jackm2983/SENIOR-PROJECT/README.md

# Senior Project 2025-26
Cal Poly SLO EE

### Team Members
* **Wyatt Tack**
* **Jack Marshall**
* **Ryken Thompson**
* **Cameron Young**

### Advisor
* **Dr. Nishith Chakraborty**

## Software
* Vivado 2024.2
* OpenLane & Magic VLSI

## Photos
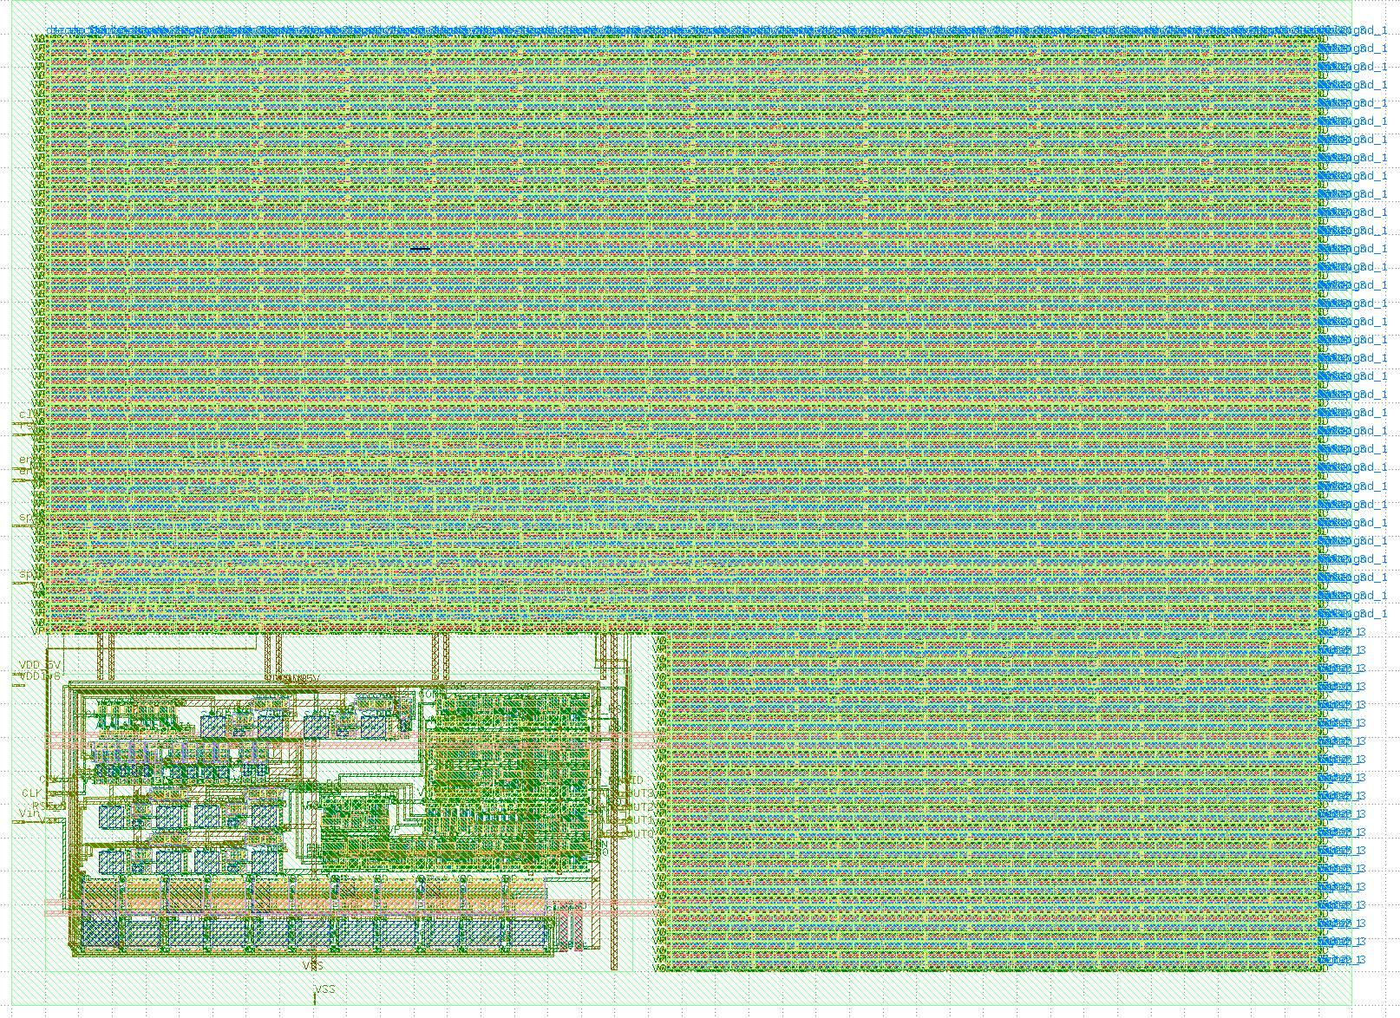
[picture p1: Misc/Photos/klayout_final.png]

*KLayout final layout*

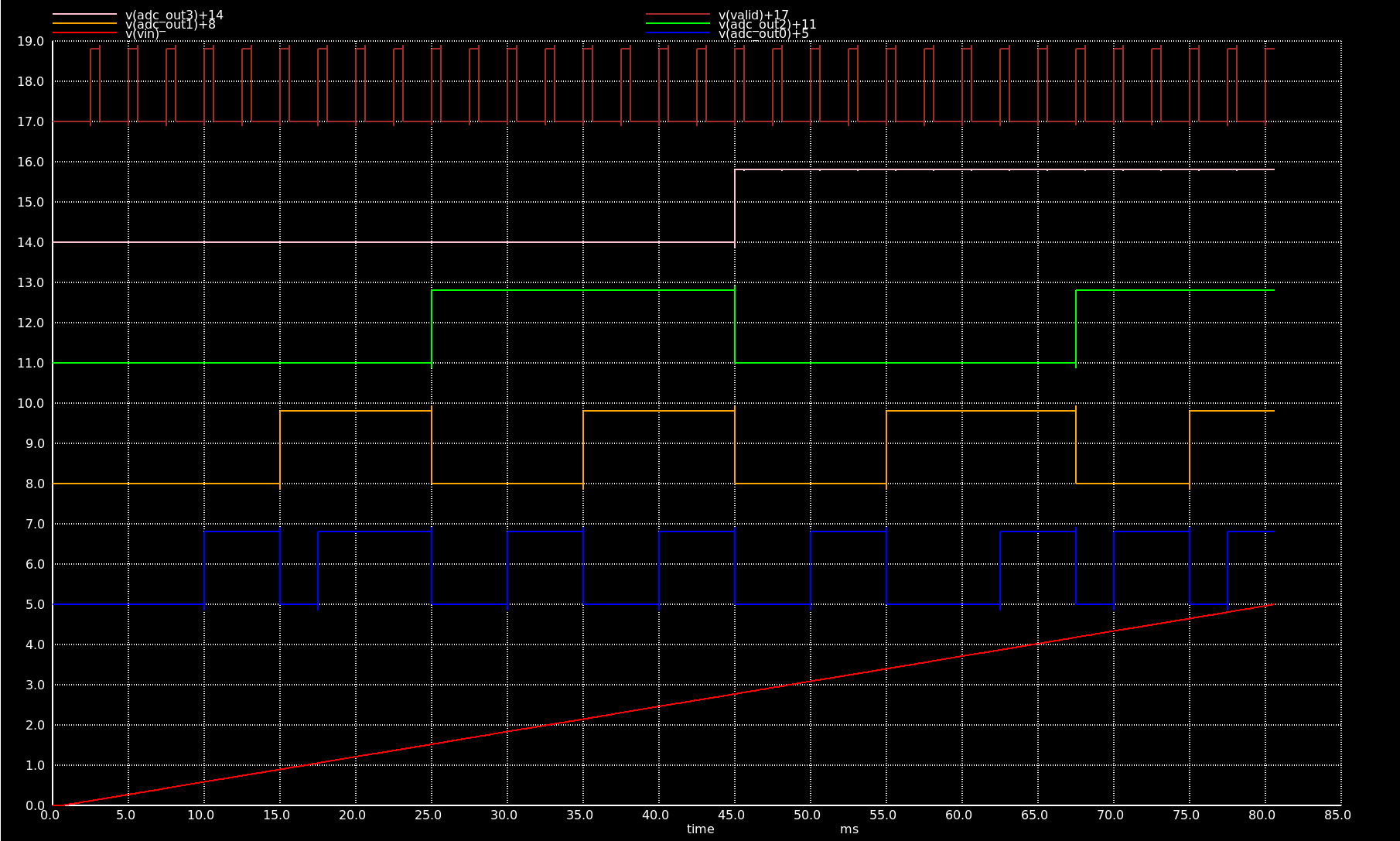
[picture p2: Misc/Photos/ADC_paracitic_noreset.png]

*ADC full-scale range simulation*


*Encoding Schemes*
