jackm2983/SENIOR-PROJECT/FPGA/README.md

SNN_Encoder is the proof of concept for the spike encoder designs. 

FPGA_Encoder+SNN+UART is the complete design with FPGA implementation and UART communication.
