jackm2983/SENIOR-PROJECT/ADC/4bit_C2C/CDAC Implementation Notes.pdf

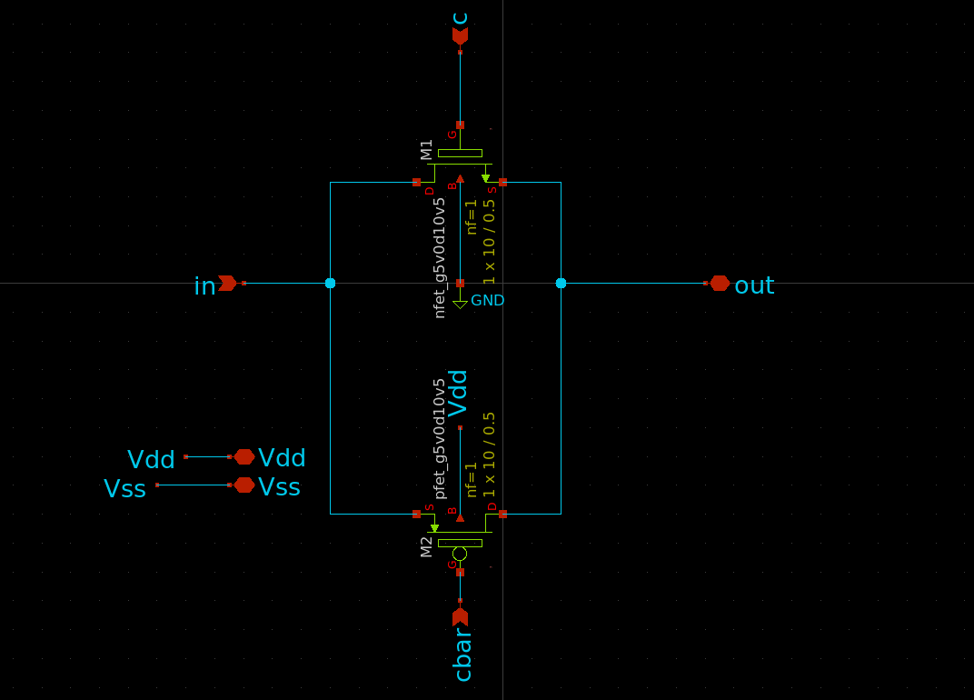
[picture p7: figure]

T Gate Schematic

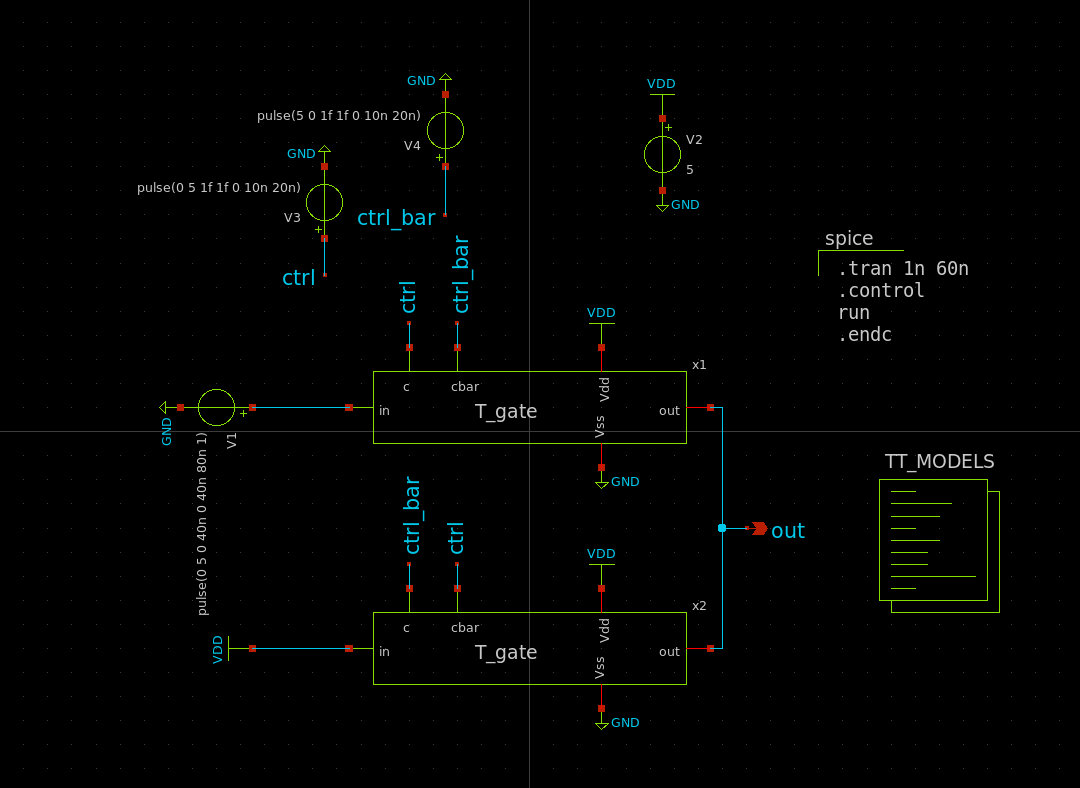
[picture p8: figure]

T-Gate SPDT Switch Operation Test Bench

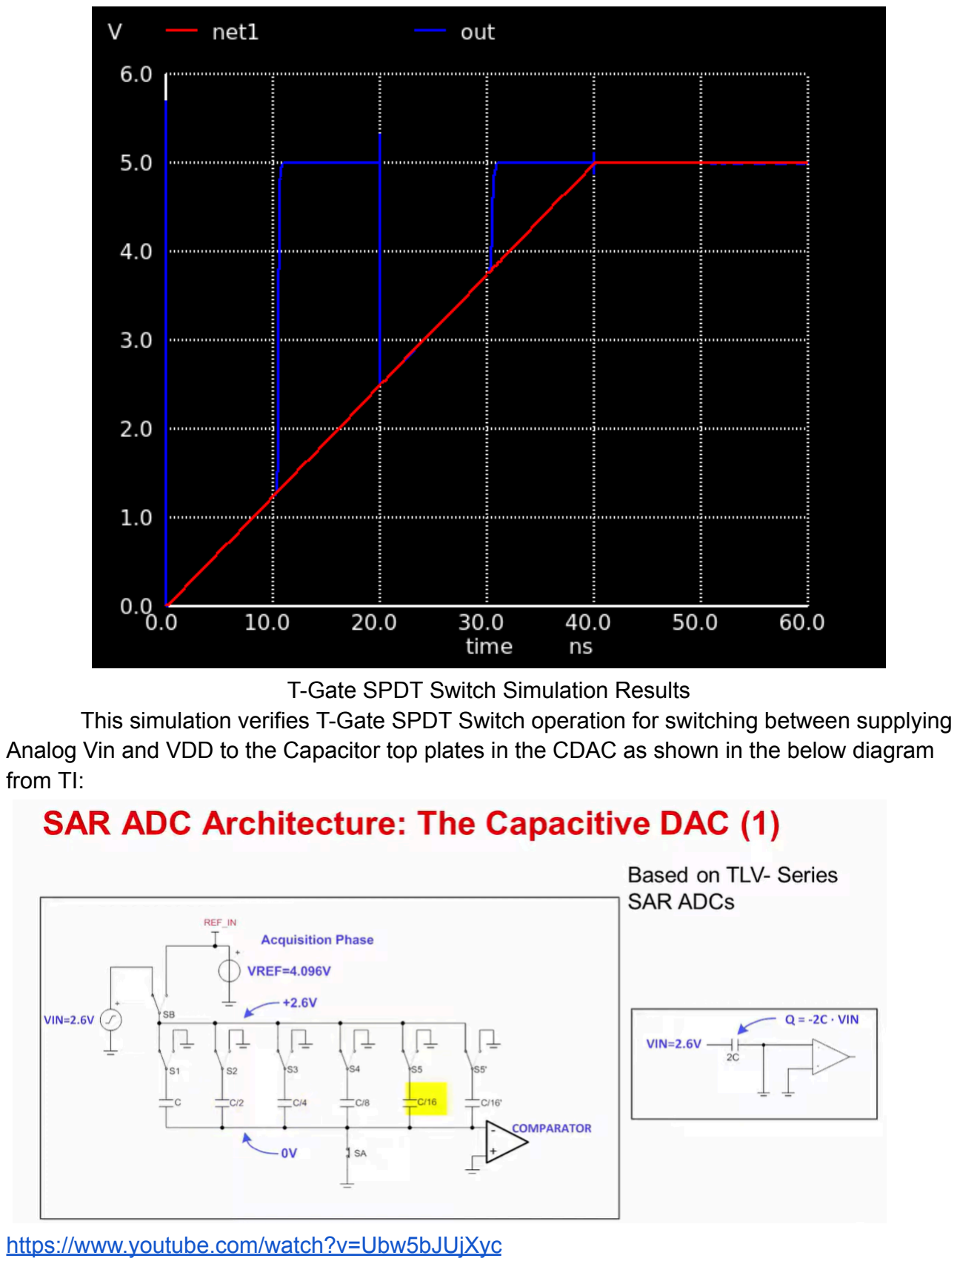
[picture p9: page 3]

T-Gate SPDT Switch Simulation Results This simulation verifies T-Gate SPDT Switch operation for switching between supplying Analog Vin and VDD to the Capacitor top plates in the CDAC as shown in the below diagram from TI:

https://www.youtube.com/watch?v=Ubw5bJUjXyc

Next, for more compact simulation at the top level I wanted to package this SPDT switch into its own subcircuit

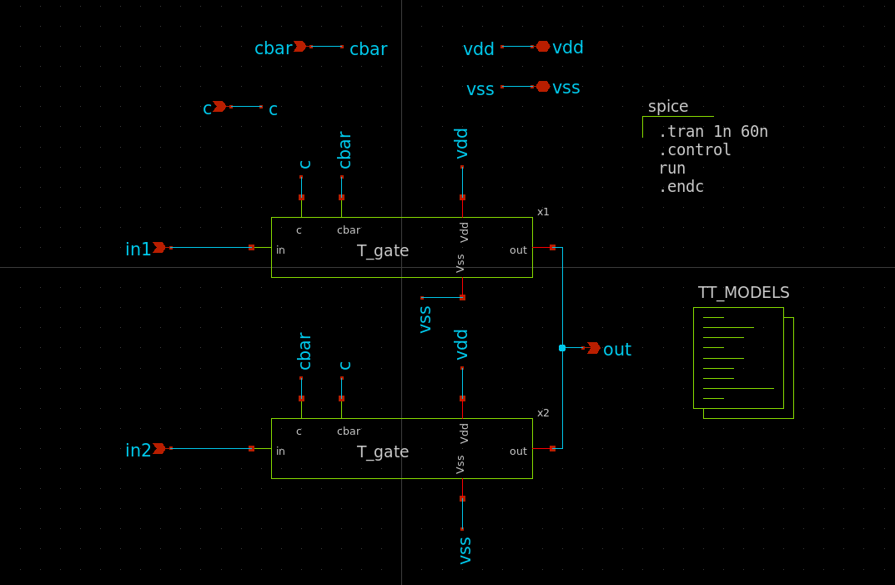
[picture p10: figure]

SPDT Schematic

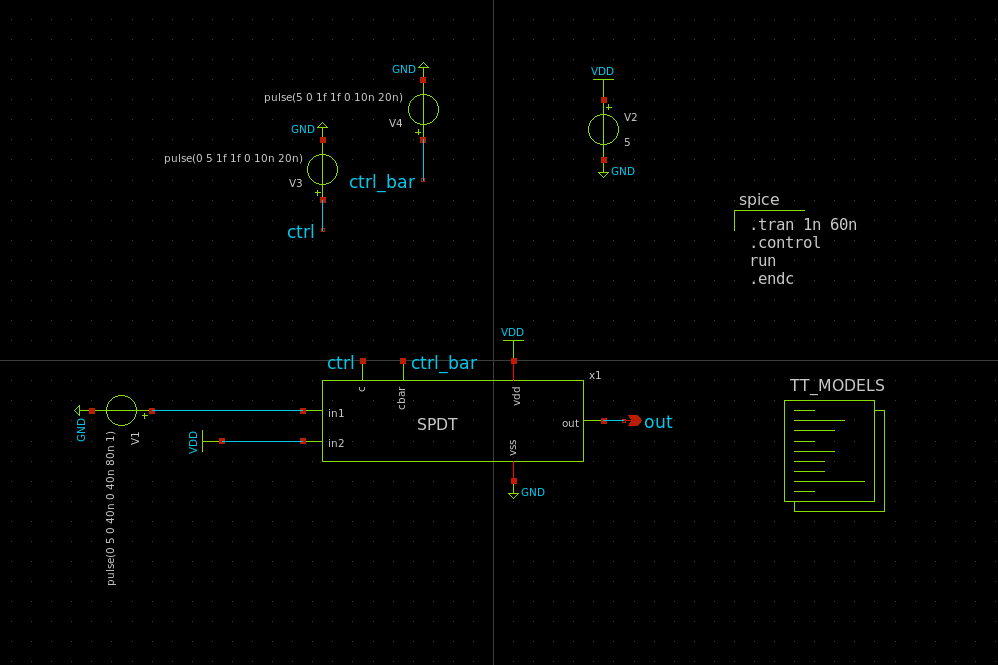
[picture p11: figure]

SPDT Test Bench

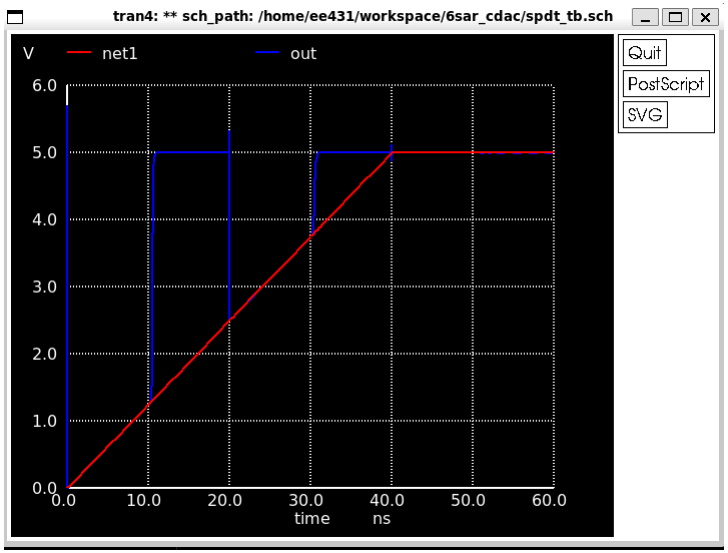
[picture p12: figure]

SPDT Simulation Results
This shows successful operation of the SPDT to pass analog inputs and VDD. This can be used in the CDAC implementation

Common mode switching CDAC

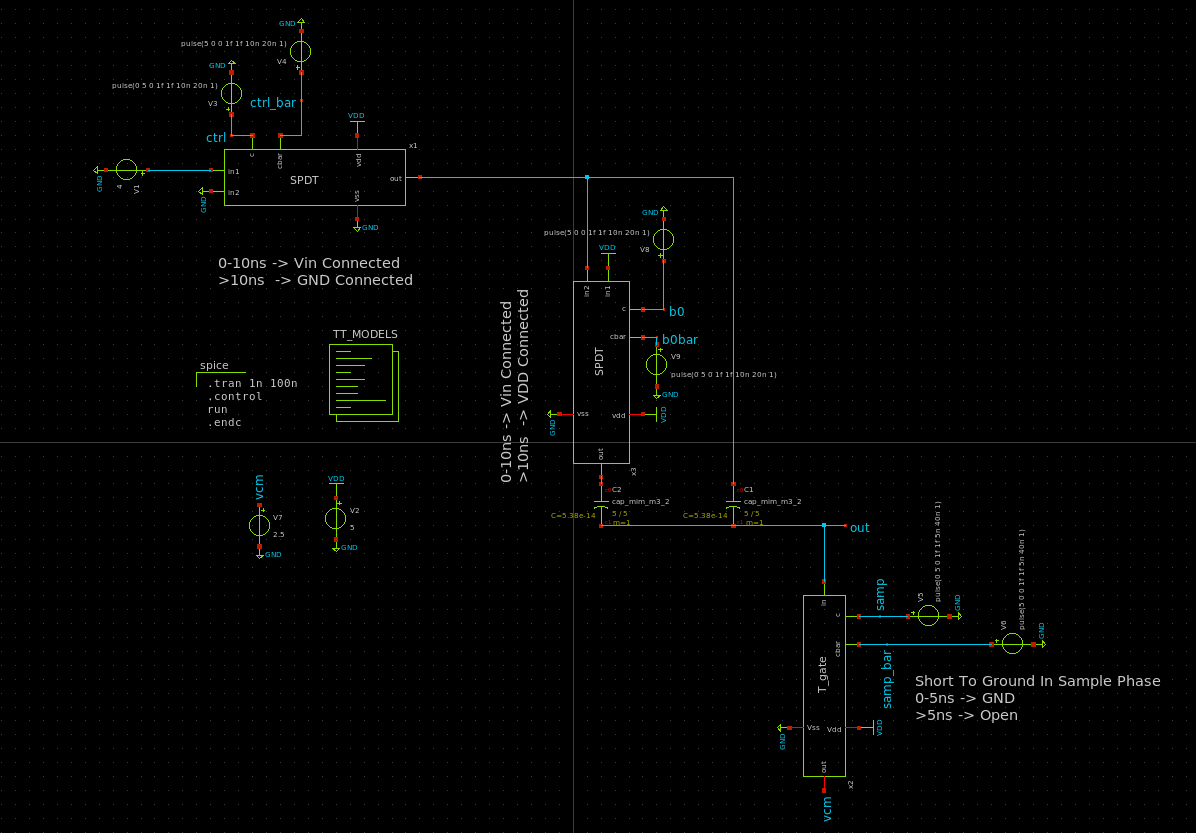
[picture p13: figure]

First Successful Common Mode Switching CDAC (1 bit)

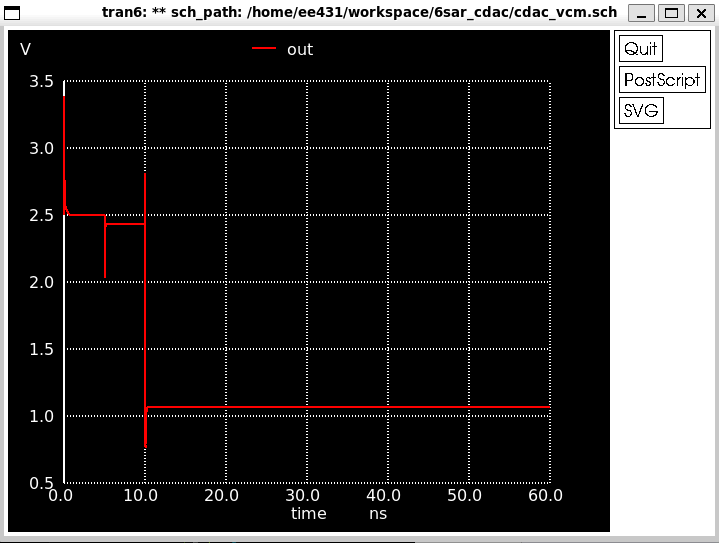
[picture p14: figure]

Simulation Results
Vout = 1V = Vcm - Vin + Vguess = 2.5 - 4 + 2.5
