jackm2983/SENIOR-PROJECT/Misc/Photos/ADC.png

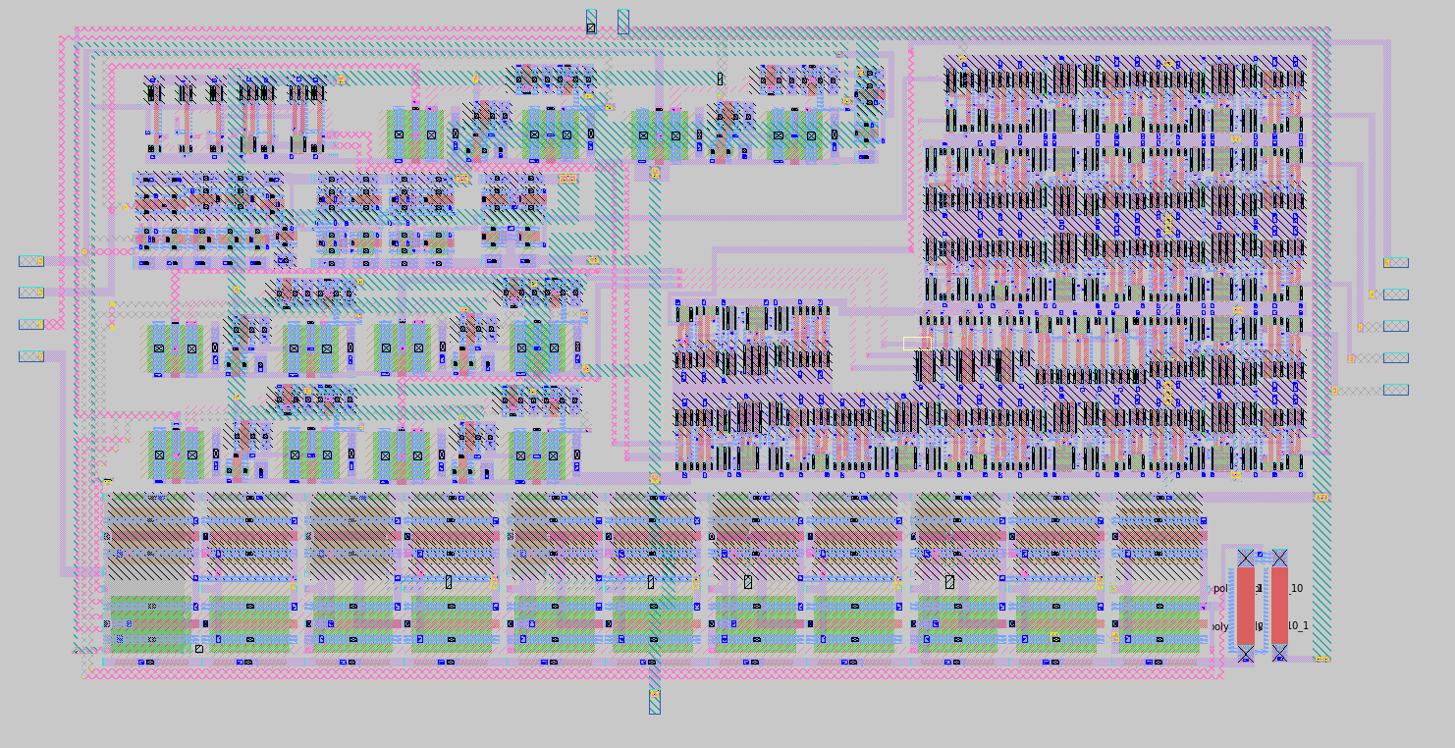
Misc/Photos/ADC.png
