jackm2983/SENIOR-PROJECT/Misc/Photos/adc_fsr_sim.png

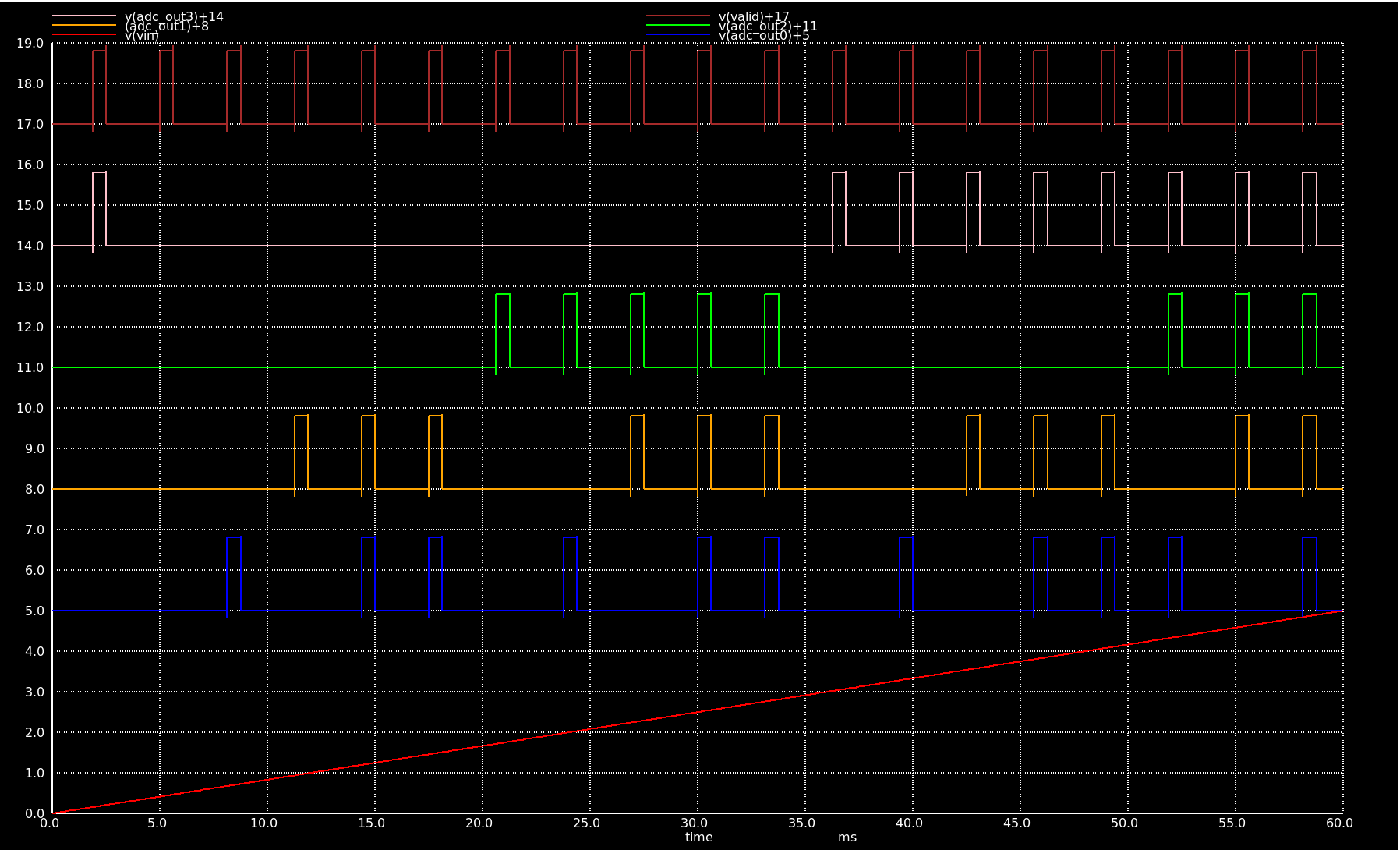
Misc/Photos/adc_fsr_sim.png
