jackm2983/SENIOR-PROJECT/Misc/Photos/adc_fsr_sim_withparacitics.png

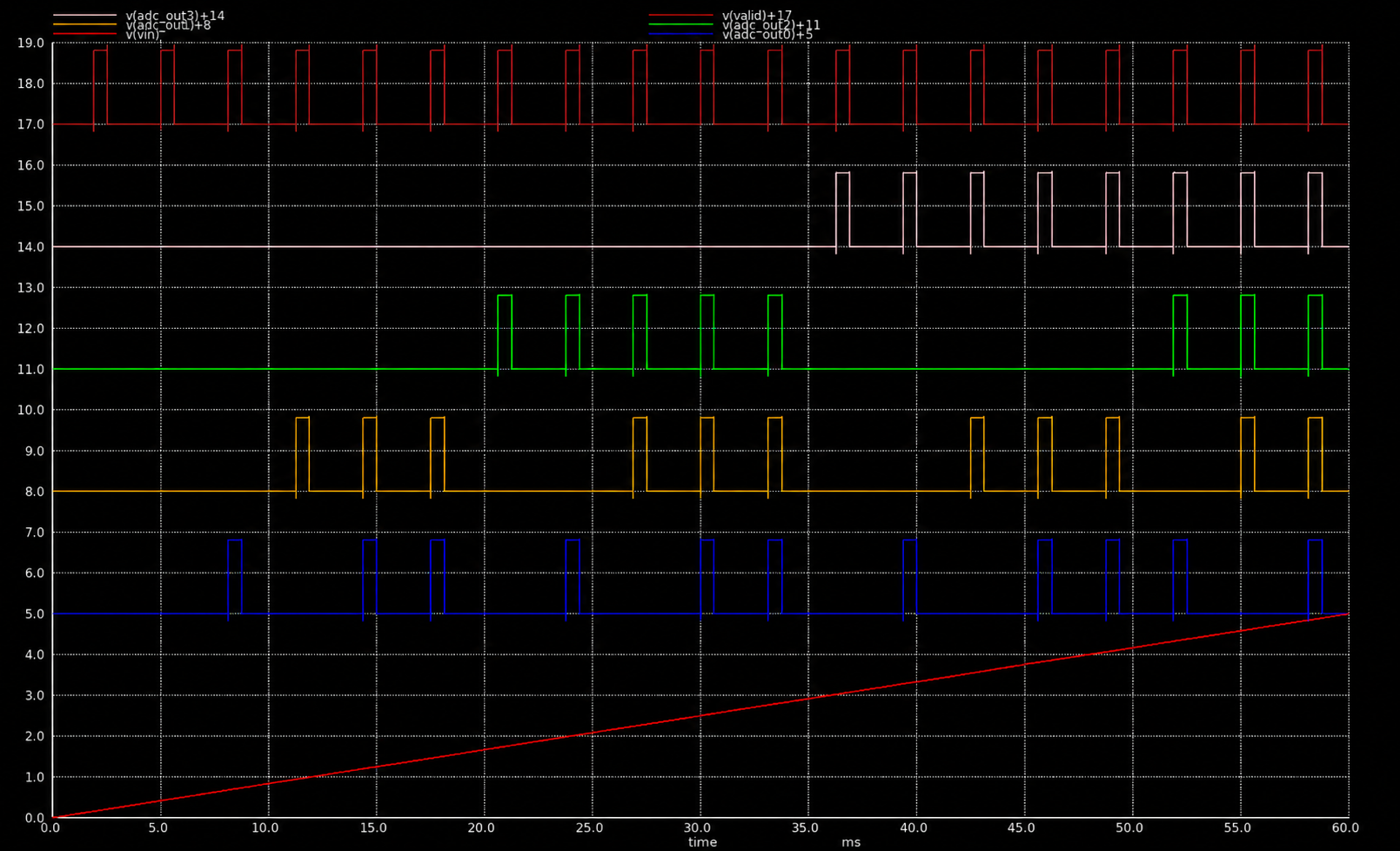
Misc/Photos/adc_fsr_sim_withparacitics.png
