jackm2983/SENIOR-PROJECT/Misc/Photos/ADC_LVS.png

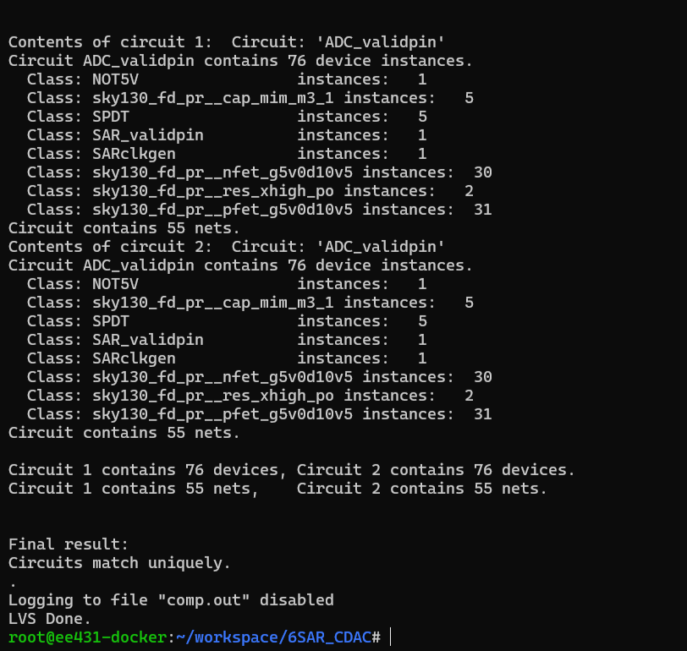
Misc/Photos/ADC_LVS.png
