jackm2983/SENIOR-PROJECT/Misc/Photos/magic_asic_adc_inthe_center.png

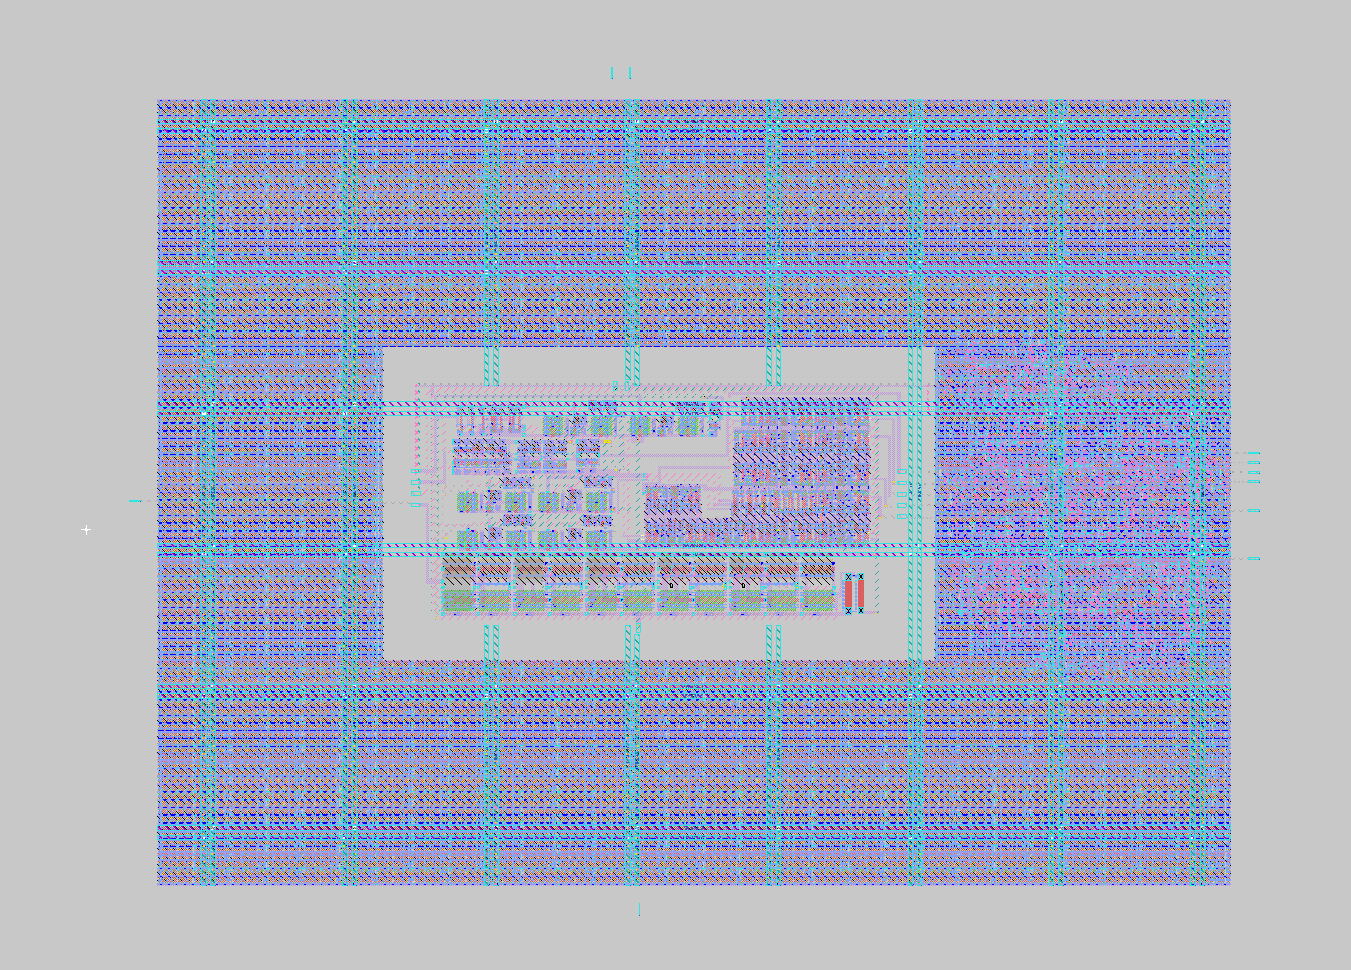
Misc/Photos/magic_asic_adc_inthe_center.png
