jackm2983/SENIOR-PROJECT/Misc/Photos/magic_asic_noadc.png

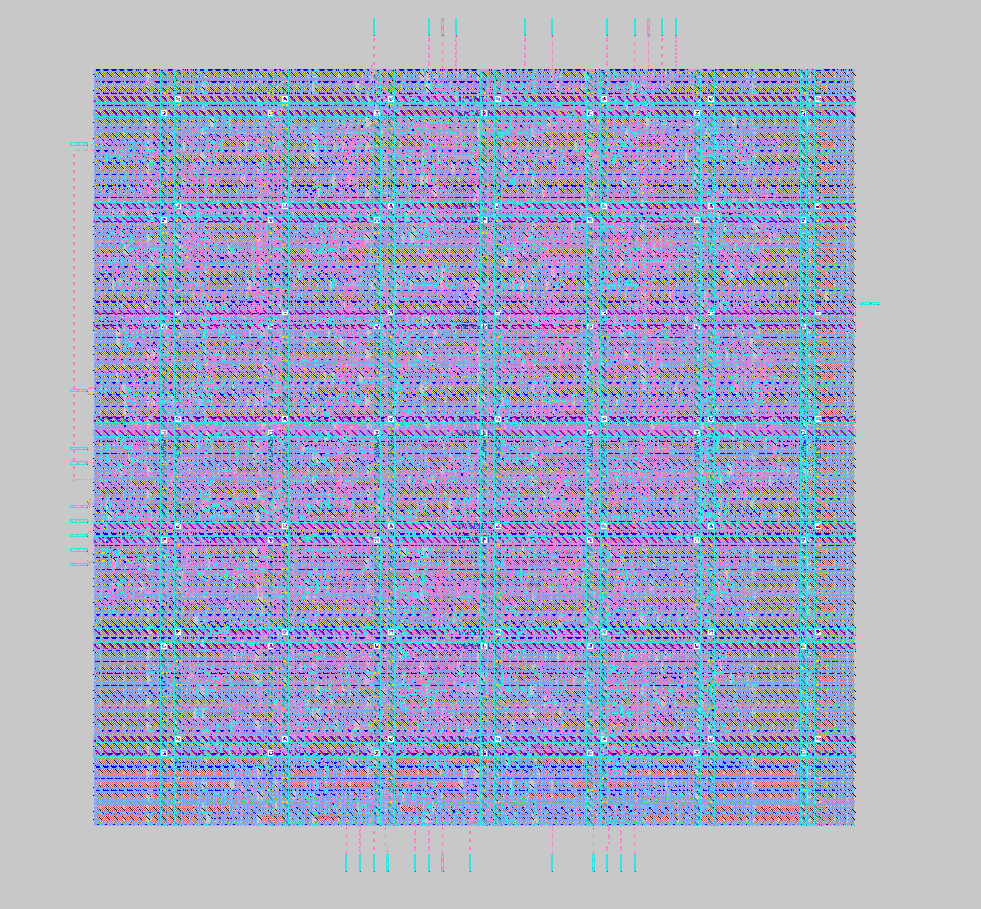
Misc/Photos/magic_asic_noadc.png
