jackm2983/SENIOR-PROJECT/Misc/Photos/overall_schematicpng.png

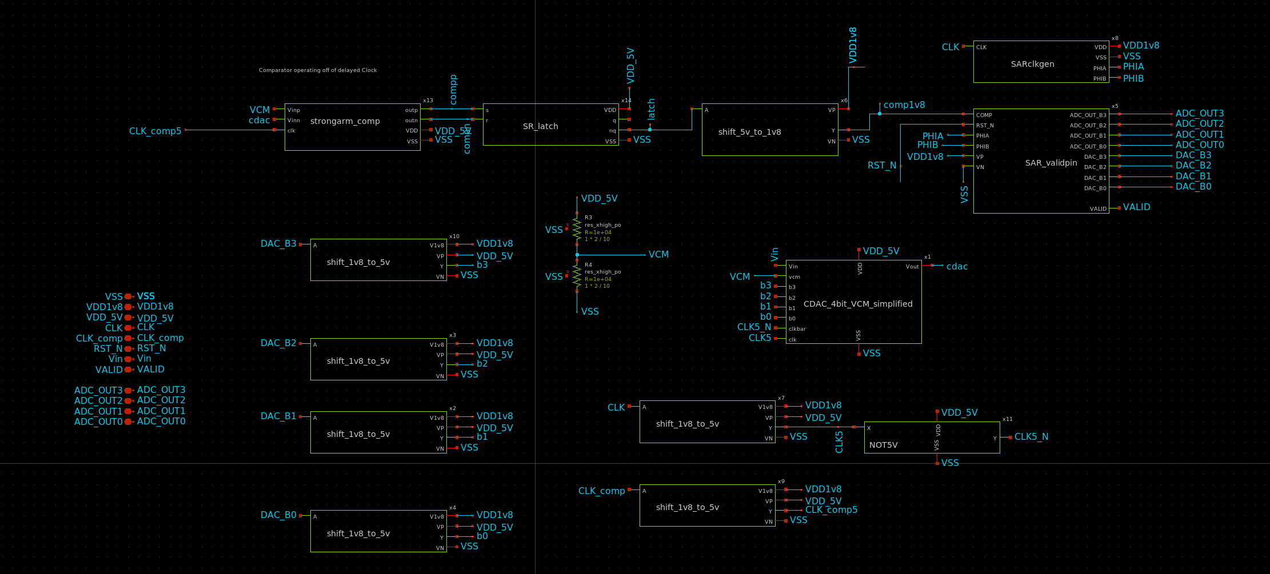
Misc/Photos/overall_schematicpng.png
