jackm2983/SENIOR-PROJECT/ADC/8bit_R2R/FETDFF(debug).asc

M1: nmos; sky130_fd_pr__nfet_01v8
M2: pmos; sky130_fd_pr__pfet_01v8
M3: nmos; sky130_fd_pr__nfet_01v8
M4: pmos; sky130_fd_pr__pfet_01v8
M5: nmos; sky130_fd_pr__nfet_01v8
M6: pmos; sky130_fd_pr__pfet_01v8
M7: nmos; sky130_fd_pr__nfet_01v8
M8: pmos; sky130_fd_pr__pfet_01v8
M9: nmos; sky130_fd_pr__nfet_01v8
M10: pmos; sky130_fd_pr__pfet_01v8
M11: nmos; sky130_fd_pr__nfet_01v8
M12: pmos; sky130_fd_pr__pfet_01v8
M13: nmos; sky130_fd_pr__nfet_01v8
M14: pmos; sky130_fd_pr__pfet_01v8
M15: nmos; sky130_fd_pr__nfet_01v8
M16: pmos; sky130_fd_pr__pfet_01v8
M17: nmos; sky130_fd_pr__nfet_01v8
M18: pmos; sky130_fd_pr__pfet_01v8
M19: nmos; sky130_fd_pr__nfet_01v8
M20: pmos; sky130_fd_pr__pfet_01v8
M21: nmos; sky130_fd_pr__nfet_01v8
M22: pmos; sky130_fd_pr__pfet_01v8
M23: nmos; sky130_fd_pr__nfet_01v8
M24: pmos; sky130_fd_pr__pfet_01v8
M25: nmos; sky130_fd_pr__nfet_01v8
M26: pmos; sky130_fd_pr__pfet_01v8
M27: nmos; sky130_fd_pr__nfet_01v8
M28: pmos; sky130_fd_pr__pfet_01v8
M29: nmos; sky130_fd_pr__nfet_01v8
M30: pmos; sky130_fd_pr__pfet_01v8
M31: nmos; sky130_fd_pr__nfet_01v8
M32: pmos; sky130_fd_pr__pfet_01v8
M33: nmos; sky130_fd_pr__nfet_01v8
M34: pmos; sky130_fd_pr__pfet_01v8
M35: nmos; sky130_fd_pr__nfet_01v8
M36: pmos; sky130_fd_pr__pfet_01v8
M37: nmos; sky130_fd_pr__nfet_01v8
M38: pmos; sky130_fd_pr__pfet_01v8
M39: nmos; sky130_fd_pr__nfet_01v8
M40: pmos; sky130_fd_pr__pfet_01v8
M41: nmos; sky130_fd_pr__nfet_01v8
M42: pmos; sky130_fd_pr__pfet_01v8
M43: nmos; sky130_fd_pr__nfet_01v8
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
M117: nmos; sky130_fd_pr__nfet_01v8
M118: pmos; sky130_fd_pr__pfet_01v8
M119: nmos; sky130_fd_pr__nfet_01v8
M120: pmos; sky130_fd_pr__pfet_01v8
V1: voltage; 3.3
V2: voltage; PULSE(0 3.3 0.1m 1n 1n 0.5m 1m)
V3: voltage; PULSE(0 3.3 0 1n 1n 1m 2m)
Named nets: 0, 3V, D, clk, D0, D1, D2
.tran 4m
