jackm2983/SENIOR-PROJECT/ADC/8bit_R2R/R2R.asc

M1: nmos; sky130_fd_pr__nfet_01v8
M2: pmos; sky130_fd_pr__pfet_01v8
M3: nmos; sky130_fd_pr__nfet_01v8
M4: pmos; sky130_fd_pr__pfet_01v8
M5: nmos; sky130_fd_pr__nfet_01v8
M6: pmos; sky130_fd_pr__pfet_01v8
M7: nmos; sky130_fd_pr__nfet_01v8
M8: pmos; sky130_fd_pr__pfet_01v8
M9: nmos; sky130_fd_pr__nfet_01v8
M10: pmos; sky130_fd_pr__pfet_01v8
M11: nmos; sky130_fd_pr__nfet_01v8
M12: pmos; sky130_fd_pr__pfet_01v8
M13: nmos; sky130_fd_pr__nfet_01v8
M14: pmos; sky130_fd_pr__pfet_01v8
M15: nmos; sky130_fd_pr__nfet_01v8
M16: pmos; sky130_fd_pr__pfet_01v8
M17: nmos; sky130_fd_pr__nfet_01v8
M18: pmos; sky130_fd_pr__pfet_01v8
M19: nmos; sky130_fd_pr__nfet_01v8
M20: pmos; sky130_fd_pr__pfet_01v8
M21: nmos; sky130_fd_pr__nfet_01v8
M22: pmos; sky130_fd_pr__pfet_01v8
M23: nmos; sky130_fd_pr__nfet_01v8
M24: pmos; sky130_fd_pr__pfet_01v8
M25: nmos; sky130_fd_pr__nfet_01v8
M26: pmos; sky130_fd_pr__pfet_01v8
M27: nmos; sky130_fd_pr__nfet_01v8
M28: pmos; sky130_fd_pr__pfet_01v8
R1: res; {mc(20k, tol)}
R2: res; {mc(20k, tol)}
R3: res; {mc(20k, tol)}
R4: res; {mc(20k, tol)}
R5: res; {mc(10k, tol)}
R6: res; {mc(10k, tol)}
R7: res; {mc(20k, tol)}
R8: res; {mc(20k, tol)}
R9: res; {mc(20k, tol)}
R10: res; {mc(20k, tol)}
R11: res; {mc(10k, tol)}
R12: res; {mc(10k, tol)}
R13: res; {mc(10k, tol)}
R14: res; {mc(20k, tol)}
R15: res; {mc(20k, tol)}
R16: res; {mc(10k, tol)}
R17: res; {mc(10k, tol)}
R18: res; {mc(10k, tol)}
R19: res; {mc(20k, tol)}
R20: res; {mc(20k, tol)}
R21: res; {mc(20k, tol)}
R22: res; {mc(10k, tol)}
R23: res; {mc(10k, tol)}
R24: res; {mc(10k, tol)}
R25: res; {mc(1Meg, tol)}
R26: res; {mc(1Meg, tol)}
V1: voltage; 1.8
V2: voltage; PULSE(0 3.3 0 1n 1n 0.5u 1u)
V3: voltage; PULSE(0 3.3 0 1n 1n 1u 2u)
V4: voltage; PULSE(0 3.3 0 1n 1n 2u 4u)
V5: voltage; PULSE(0 3.3 0 1n 1n 4u 8u)
V6: voltage; PULSE(0 3.3 0 1n 1n 8u 16u)
V7: voltage; PULSE(0 3.3 0 1n 1n 16u 32u)
V8: voltage; PULSE(0 3.3 0 1n 1n 32u 64u)
V9: voltage; PULSE(0 3.3 0 1n 1n 64u 128u)
V10: voltage; PULSE(0 3.3 0 1n 1n 128u 256u)
V11: voltage; PULSE(0 3.3 0 1n 1n 256u 512u)
V12: voltage; PULSE(0 3.3 0 1n 1n 512u 1024u)
V13: voltage; PULSE(0 3.3 0 1n 1n 1024u 2048u)
V14: voltage; 3.3
Named nets: 0, B0, 1.8V, B1, B2, B9, B10, B11, B3, B4, B5, B6, B7, B8, 3V, V0
.tran 2.05m
.meas TRAN Voutavg RMS (V(V0))
.meas TRAN Voutmax MAX (V(V0))
.meas TRAN Voutmin MIN (V(V0))
.param tol 0.01
.step param run 0 9 1
.step param temp 0 100 10
