jackm2983/SENIOR-PROJECT/ADC/4bit_C2C/MagicAndSpice/postlayout.spice

* NGSPICE file created from ADC_validpin.ext - technology: sky130A

X0 CDAC_0/Vcm VSS VSS sky130_fd_pr__res_xhigh_po w=2 l=10.01
X1 shift1v8to5_0/5v_pfet_1_2_2/D shift1v8to5_0/A VSS VSS sky130_fd_pr__nfet_g5v0d10v5 ad=18 pd=18 as=16.25 ps=18.375 w=6 l=1
X2 CDAC_0/b1 shift1v8to5_0/5v_pfet_1_2_0/D VSS VSS sky130_fd_pr__nfet_g5v0d10v5 ad=18 pd=16.5 as=16.25 ps=18.375 w=6 l=1
X3 shift1v8to5_0/5v_pfet_1_2_0/D shift1v8to5_0/A VDD1v8 VDD1v8 sky130_fd_pr__pfet_g5v0d10v5 ad=2 pd=6 as=2 ps=6 w=2 l=1
X4 CDAC_0/b1 shift1v8to5_0/5v_pfet_1_2_2/D VDD_5V VDD_5V sky130_fd_pr__pfet_g5v0d10v5 ad=5.333333 pd=5.333333 as=2 ps=6.190476 w=2 l=1
X5 shift1v8to5_0/5v_pfet_1_2_2/D CDAC_0/b1 VDD_5V VDD_5V sky130_fd_pr__pfet_g5v0d10v5 ad=2 pd=6 as=2 ps=6.190476 w=2 l=1
X6 shift1v8to5_0/5v_pfet_1_2_0/D shift1v8to5_0/A VSS VSS sky130_fd_pr__nfet_g5v0d10v5 ad=1 pd=4 as=2.708333 ps=3.0625 w=1 l=1
X7 SRLatch5V_0/NQ SRLatch5V_0/Q SRLatch5V_0/NAND5v_0/5v_nfet_1_2_1/D VSS sky130_fd_pr__nfet_g5v0d10v5 ad=2 pd=6 as=2 ps=6 w=2 l=1
X8 SRLatch5V_0/NAND5v_0/5v_nfet_1_2_1/D SRLatch5V_0/R VSS VSS sky130_fd_pr__nfet_g5v0d10v5 ad=2 pd=6 as=5.416667 ps=6.125 w=2 l=1
X9 SRLatch5V_0/NQ SRLatch5V_0/Q VDD_5V VDD_5V sky130_fd_pr__pfet_g5v0d10v5 ad=2 pd=6 as=2 ps=6.190476 w=2 l=1
X10 SRLatch5V_0/NQ SRLatch5V_0/R VDD_5V VDD_5V sky130_fd_pr__pfet_g5v0d10v5 ad=2 pd=6 as=2 ps=6.190476 w=2 l=1
X11 SRLatch5V_0/Q SRLatch5V_0/S SRLatch5V_0/NAND5v_1/5v_nfet_1_2_1/D VSS sky130_fd_pr__nfet_g5v0d10v5 ad=2 pd=6 as=2 ps=6 w=2 l=1
X12 SRLatch5V_0/NAND5v_1/5v_nfet_1_2_1/D SRLatch5V_0/NQ VSS VSS sky130_fd_pr__nfet_g5v0d10v5 ad=2 pd=6 as=5.416667 ps=6.125 w=2 l=1
X13 SRLatch5V_0/Q SRLatch5V_0/S VDD_5V VDD_5V sky130_fd_pr__pfet_g5v0d10v5 ad=2 pd=6 as=2 ps=6.190476 w=2 l=1
X14 SRLatch5V_0/Q SRLatch5V_0/NQ VDD_5V VDD_5V sky130_fd_pr__pfet_g5v0d10v5 ad=2 pd=6 as=2 ps=6.190476 w=2 l=1
X15 CDAC_0/Vcm VDD_5V VSS sky130_fd_pr__res_xhigh_po w=2 l=10.01
X16 shift1v8to5_1/5v_pfet_1_2_2/D shift1v8to5_1/A VSS VSS sky130_fd_pr__nfet_g5v0d10v5 ad=18 pd=18 as=16.25 ps=18.375 w=6 l=1
X17 CDAC_0/b0 shift1v8to5_1/5v_pfet_1_2_0/D VSS VSS sky130_fd_pr__nfet_g5v0d10v5 ad=18 pd=16.5 as=16.25 ps=18.375 w=6 l=1
X18 shift1v8to5_1/5v_pfet_1_2_0/D shift1v8to5_1/A VDD1v8 VDD1v8 sky130_fd_pr__pfet_g5v0d10v5 ad=2 pd=6 as=2 ps=6 w=2 l=1
X19 CDAC_0/b0 shift1v8to5_1/5v_pfet_1_2_2/D VDD_5V VDD_5V sky130_fd_pr__pfet_g5v0d10v5 ad=5.333333 pd=5.333333 as=2 ps=6.190476 w=2 l=1
X20 shift1v8to5_1/5v_pfet_1_2_2/D CDAC_0/b0 VDD_5V VDD_5V sky130_fd_pr__pfet_g5v0d10v5 ad=2 pd=6 as=2 ps=6.190476 w=2 l=1
X21 shift1v8to5_1/5v_pfet_1_2_0/D shift1v8to5_1/A VSS VSS sky130_fd_pr__nfet_g5v0d10v5 ad=1 pd=4 as=2.708333 ps=3.0625 w=1 l=1
X22 shift1v8to5_2/5v_pfet_1_2_2/D shift1v8to5_2/A VSS VSS sky130_fd_pr__nfet_g5v0d10v5 ad=18 pd=18 as=16.25 ps=18.375 w=6 l=1
X23 CDAC_0/b3 shift1v8to5_2/5v_pfet_1_2_0/D VSS VSS sky130_fd_pr__nfet_g5v0d10v5 ad=18 pd=16.5 as=16.25 ps=18.375 w=6 l=1
X24 shift1v8to5_2/5v_pfet_1_2_0/D shift1v8to5_2/A VDD1v8 VDD1v8 sky130_fd_pr__pfet_g5v0d10v5 ad=2 pd=6 as=2 ps=6 w=2 l=1
X25 CDAC_0/b3 shift1v8to5_2/5v_pfet_1_2_2/D VDD_5V VDD_5V sky130_fd_pr__pfet_g5v0d10v5 ad=5.333333 pd=5.333333 as=2 ps=6.190476 w=2 l=1
X26 shift1v8to5_2/5v_pfet_1_2_2/D CDAC_0/b3 VDD_5V VDD_5V sky130_fd_pr__pfet_g5v0d10v5 ad=2 pd=6 as=2 ps=6.190476 w=2 l=1
X27 shift1v8to5_2/5v_pfet_1_2_0/D shift1v8to5_2/A VSS VSS sky130_fd_pr__nfet_g5v0d10v5 ad=1 pd=4 as=2.708333 ps=3.0625 w=1 l=1
X28 shift1v8to5_3/5v_pfet_1_2_2/D shift1v8to5_3/A VSS VSS sky130_fd_pr__nfet_g5v0d10v5 ad=18 pd=18 as=16.25 ps=18.375 w=6 l=1
X29 CDAC_0/b2 shift1v8to5_3/5v_pfet_1_2_0/D VSS VSS sky130_fd_pr__nfet_g5v0d10v5 ad=18 pd=16.5 as=16.25 ps=18.375 w=6 l=1
X30 shift1v8to5_3/5v_pfet_1_2_0/D shift1v8to5_3/A VDD1v8 VDD1v8 sky130_fd_pr__pfet_g5v0d10v5 ad=2 pd=6 as=2 ps=6 w=2 l=1
X31 CDAC_0/b2 shift1v8to5_3/5v_pfet_1_2_2/D VDD_5V VDD_5V sky130_fd_pr__pfet_g5v0d10v5 ad=5.333333 pd=5.333333 as=2 ps=6.190476 w=2 l=1
X32 shift1v8to5_3/5v_pfet_1_2_2/D CDAC_0/b2 VDD_5V VDD_5V sky130_fd_pr__pfet_g5v0d10v5 ad=2 pd=6 as=2 ps=6.190476 w=2 l=1
X33 shift1v8to5_3/5v_pfet_1_2_0/D shift1v8to5_3/A VSS VSS sky130_fd_pr__nfet_g5v0d10v5 ad=1 pd=4 as=2.708333 ps=3.0625 w=1 l=1
X34 SAR_validpin_0/OR2_0/a_100_310# SAR_validpin_0/OR2_0/B VDD1v8 VDD1v8 sky130_fd_pr__pfet_01v8 ad=0.5 pd=4.25 as=0.905774 ps=5.224219 w=4 l=0.5
X35 VSS SAR_validpin_0/OR2_0/B SAR_validpin_0/OR2_0/a_n80_n540# VSS sky130_fd_pr__nfet_01v8 ad=0.310542 pd=1.943976 as=0.4 ps=2.8 w=1 l=0.5
X36 SAR_validpin_0/OR2_0/a_n80_n540# SAR_validpin_0/OR2_0/A VSS VSS sky130_fd_pr__nfet_01v8 ad=0.4 pd=2.8 as=0.310542 ps=1.943976 w=1 l=0.5
X37 SAR_validpin_0/OR2_0/a_n80_n540# SAR_validpin_0/OR2_0/A SAR_validpin_0/OR2_0/a_100_310# VDD1v8 sky130_fd_pr__pfet_01v8 ad=1.4 pd=8.7 as=0.5 ps=4.25 w=4 l=0.5
X38 shift1v8to5_0/A SAR_validpin_0/OR2_0/a_n80_n540# VSS VSS sky130_fd_pr__nfet_01v8 ad=0.4 pd=2.8 as=0.310542 ps=1.943976 w=1 l=0.5
X39 shift1v8to5_0/A SAR_validpin_0/OR2_0/a_n80_n540# VDD1v8 VDD1v8 sky130_fd_pr__pfet_01v8 ad=0.8 pd=4.8 as=0.452887 ps=2.61211 w=2 l=0.5
X40 SAR_validpin_0/OR2_1/a_100_310# SAR_validpin_0/OR2_1/B VDD1v8 VDD1v8 sky130_fd_pr__pfet_01v8 ad=0.5 pd=4.25 as=0.905774 ps=5.224219 w=4 l=0.5
X41 VSS SAR_validpin_0/OR2_1/B SAR_validpin_0/OR2_1/a_n80_n540# VSS sky130_fd_pr__nfet_01v8 ad=0.310542 pd=1.943976 as=0.4 ps=2.8 w=1 l=0.5
X42 SAR_validpin_0/OR2_1/a_n80_n540# SAR_validpin_0/OR2_1/A VSS VSS sky130_fd_pr__nfet_01v8 ad=0.4 pd=2.8 as=0.310542 ps=1.943976 w=1 l=0.5
X43 SAR_validpin_0/OR2_1/a_n80_n540# SAR_validpin_0/OR2_1/A SAR_validpin_0/OR2_1/a_100_310# VDD1v8 sky130_fd_pr__pfet_01v8 ad=1.4 pd=8.7 as=0.5 ps=4.25 w=4 l=0.5
X44 shift1v8to5_3/A SAR_validpin_0/OR2_1/a_n80_n540# VSS VSS sky130_fd_pr__nfet_01v8 ad=0.4 pd=2.8 as=0.310542 ps=1.943976 w=1 l=0.5
X45 shift1v8to5_3/A SAR_validpin_0/OR2_1/a_n80_n540# VDD1v8 VDD1v8 sky130_fd_pr__pfet_01v8 ad=0.8 pd=4.8 as=0.452887 ps=2.61211 w=2 l=0.5
X46 SAR_validpin_0/DFFRR_1/D SAR_validpin_0/2_1_MUX_0/a_n1230_n310# SAR_validpin_0/OR2_0/A VSS sky130_fd_pr__nfet_01v8 ad=1.35 pd=6.9 as=1.3125 ps=7.275 w=3 l=0.5
X47 SAR_validpin_0/DFFRR_1/D SAR_validpin_0/OR2_0/B SAR_validpin_0/OR2_0/A VDD1v8 sky130_fd_pr__pfet_01v8 ad=1.35 pd=6.9 as=1.29 ps=7.02 w=3 l=0.5
X48 SAR_validpin_0/2_1_MUX_0/a_n1230_n310# SAR_validpin_0/OR2_0/B VDD1v8 VDD1v8 sky130_fd_pr__pfet_01v8 ad=0.9 pd=4.9 as=0.452887 ps=2.61211 w=2 l=0.5
X49 SAR_validpin_0/2_1_MUX_0/a_n1230_n310# SAR_validpin_0/OR2_0/B VSS VSS sky130_fd_pr__nfet_01v8 ad=0.45 pd=2.9 as=0.310542 ps=1.943976 w=1 l=0.5
X50 shift5to1v8_0/Y SAR_validpin_0/2_1_MUX_0/a_n1230_n310# SAR_validpin_0/DFFRR_1/D VDD1v8 sky130_fd_pr__pfet_01v8 ad=1.35 pd=6.9 as=1.35 ps=6.9 w=3 l=0.5
X51 shift5to1v8_0/Y SAR_validpin_0/OR2_0/B SAR_validpin_0/DFFRR_1/D VSS sky130_fd_pr__nfet_01v8 ad=1.35 pd=6.9 as=1.35 ps=6.9 w=3 l=0.5
X52 SAR_validpin_0/OR2_2/a_100_310# SAR_validpin_0/OR2_2/B VDD1v8 VDD1v8 sky130_fd_pr__pfet_01v8 ad=0.5 pd=4.25 as=0.905774 ps=5.224219 w=4 l=0.5
X53 VSS SAR_validpin_0/OR2_2/B SAR_validpin_0/OR2_2/a_n80_n540# VSS sky130_fd_pr__nfet_01v8 ad=0.310542 pd=1.943976 as=0.4 ps=2.8 w=1 l=0.5
X54 SAR_validpin_0/OR2_2/a_n80_n540# SAR_validpin_0/OR2_2/A VSS VSS sky130_fd_pr__nfet_01v8 ad=0.4 pd=2.8 as=0.310542 ps=1.943976 w=1 l=0.5
X55 SAR_validpin_0/OR2_2/a_n80_n540# SAR_validpin_0/OR2_2/A SAR_validpin_0/OR2_2/a_100_310# VDD1v8 sky130_fd_pr__pfet_01v8 ad=1.4 pd=8.7 as=0.5 ps=4.25 w=4 l=0.5
X56 shift1v8to5_2/A SAR_validpin_0/OR2_2/a_n80_n540# VSS VSS sky130_fd_pr__nfet_01v8 ad=0.4 pd=2.8 as=0.310542 ps=1.943976 w=1 l=0.5
X57 shift1v8to5_2/A SAR_validpin_0/OR2_2/a_n80_n540# VDD1v8 VDD1v8 sky130_fd_pr__pfet_01v8 ad=0.8 pd=4.8 as=0.452887 ps=2.61211 w=2 l=0.5
X58 SAR_validpin_0/DFFRR_0/D SAR_validpin_0/2_1_MUX_1/a_n1230_n310# SAR_validpin_0/OR2_1/A VSS sky130_fd_pr__nfet_01v8 ad=1.35 pd=6.9 as=1.3125 ps=7.275 w=3 l=0.5
X59 SAR_validpin_0/DFFRR_0/D SAR_validpin_0/OR2_1/B SAR_validpin_0/OR2_1/A VDD1v8 sky130_fd_pr__pfet_01v8 ad=1.35 pd=6.9 as=1.29 ps=7.02 w=3 l=0.5
X60 SAR_validpin_0/2_1_MUX_1/a_n1230_n310# SAR_validpin_0/OR2_1/B VDD1v8 VDD1v8 sky130_fd_pr__pfet_01v8 ad=0.9 pd=4.9 as=0.452887 ps=2.61211 w=2 l=0.5
X61 SAR_validpin_0/2_1_MUX_1/a_n1230_n310# SAR_validpin_0/OR2_1/B VSS VSS sky130_fd_pr__nfet_01v8 ad=0.45 pd=2.9 as=0.310542 ps=1.943976 w=1 l=0.5
X62 shift5to1v8_0/Y SAR_validpin_0/2_1_MUX_1/a_n1230_n310# SAR_validpin_0/DFFRR_0/D VDD1v8 sky130_fd_pr__pfet_01v8 ad=1.35 pd=6.9 as=1.35 ps=6.9 w=3 l=0.5
X63 shift5to1v8_0/Y SAR_validpin_0/OR2_1/B SAR_validpin_0/DFFRR_0/D VSS sky130_fd_pr__nfet_01v8 ad=1.35 pd=6.9 as=1.35 ps=6.9 w=3 l=0.5
X64 SAR_validpin_0/DFFR_7/D SAR_validpin_0/2_1_MUX_2/a_n1230_n310# SAR_validpin_0/OR2_2/A VSS sky130_fd_pr__nfet_01v8 ad=1.35 pd=6.9 as=1.3125 ps=7.275 w=3 l=0.5
X65 SAR_validpin_0/DFFR_7/D SAR_validpin_0/OR2_2/B SAR_validpin_0/OR2_2/A VDD1v8 sky130_fd_pr__pfet_01v8 ad=1.35 pd=6.9 as=1.29 ps=7.02 w=3 l=0.5
X66 SAR_validpin_0/2_1_MUX_2/a_n1230_n310# SAR_validpin_0/OR2_2/B VDD1v8 VDD1v8 sky130_fd_pr__pfet_01v8 ad=0.9 pd=4.9 as=0.452887 ps=2.61211 w=2 l=0.5
X67 SAR_validpin_0/2_1_MUX_2/a_n1230_n310# SAR_validpin_0/OR2_2/B VSS VSS sky130_fd_pr__nfet_01v8 ad=0.45 pd=2.9 as=0.310542 ps=1.943976 w=1 l=0.5
X68 shift5to1v8_0/Y SAR_validpin_0/2_1_MUX_2/a_n1230_n310# SAR_validpin_0/DFFR_7/D VDD1v8 sky130_fd_pr__pfet_01v8 ad=1.35 pd=6.9 as=1.35 ps=6.9 w=3 l=0.5
X69 shift5to1v8_0/Y SAR_validpin_0/OR2_2/B SAR_validpin_0/DFFR_7/D VSS sky130_fd_pr__nfet_01v8 ad=1.35 pd=6.9 as=1.35 ps=6.9 w=3 l=0.5
X70 SAR_validpin_0/DFFR_0/a_2090_n400# SAR_validpin_0/DFFR_0/a_n50_n400# SAR_validpin_0/DFFR_0/a_450_n400# VDD1v8 sky130_fd_pr__pfet_01v8 ad=1.38 pd=7.08 as=1.2 ps=6.96 w=3 l=0.5
X71 VDD1v8 SAR_validpin_0/DFFR_0/a_2090_n400# SAR_validpin_0/DFFR_0/a_2600_n430# VDD1v8 sky130_fd_pr__pfet_01v8 ad=0.452887 pd=2.61211 as=0.8 ps=4.8 w=2 l=0.5
X72 VSS SARclkgen_0/PHIB SAR_validpin_0/DFFR_0/a_n420_n400# VSS sky130_fd_pr__nfet_01v8 ad=0.310542 pd=1.943976 as=0.4 ps=2.8 w=1 l=0.5
X73 SAR_validpin_0/DFFR_0/a_2550_n400# SAR_validpin_0/DFFR_0/a_n50_n400# SAR_validpin_0/DFFR_0/a_2090_n400# VSS sky130_fd_pr__nfet_01v8 ad=0.125 pd=1.25 as=0.475 ps=2.45 w=1 l=0.5
X74 VSS SAR_validpin_0/DFFR_0/a_2600_n430# SAR_validpin_0/DFFR_0/a_2550_n400# VSS sky130_fd_pr__nfet_01v8 ad=0.310542 pd=1.943976 as=0.125 ps=1.25 w=1 l=0.5
X75 SAR_validpin_0/DFFR_0/a_1460_n400# SAR_validpin_0/DFFR_0/a_450_n400# SAR_validpin_0/DFFR_0/a_1310_n400# VSS sky130_fd_pr__nfet_01v8 ad=0.375 pd=3.25 as=0.375 ps=3.25 w=3 l=0.5
X76 SAR_validpin_0/DFFR_0/a_350_n430# SAR_validpin_0/DFFR_0/a_n420_n400# SAR_validpin_0/DFFR_0/a_1460_n400# VSS sky130_fd_pr__nfet_01v8 ad=1.2 pd=6.8 as=0.375 ps=3.25 w=3 l=0.5
X77 VSS RST_N SAR_validpin_0/DFFR_0/a_3210_n400# VSS sky130_fd_pr__nfet_01v8 ad=0.621084 pd=3.887952 as=0.25 ps=2.25 w=2 l=0.5
X78 SAR_validpin_0/DFFR_0/a_90_n400# SARclkgen_0/PHIB SAR_validpin_0/DFFR_0/a_350_n430# VSS sky130_fd_pr__nfet_01v8 ad=1.425 pd=7.35 as=1.2 ps=6.8 w=3 l=0.5
X79 SAR_validpin_0/DFFR_0/a_n50_n400# SARclkgen_0/PHIA VDD1v8 VDD1v8 sky130_fd_pr__pfet_01v8 ad=0.8 pd=4.8 as=0.452887 ps=2.61211 w=2 l=0.5
X80 SAR_validpin_0/DFFR_0/a_n50_n400# SARclkgen_0/PHIA VSS VSS sky130_fd_pr__nfet_01v8 ad=0.4 pd=2.8 as=0.310542 ps=1.943976 w=1 l=0.5
X81 SAR_validpin_0/DFFR_0/a_2550_720# SARclkgen_0/PHIA SAR_validpin_0/DFFR_0/a_2090_n400# VDD1v8 sky130_fd_pr__pfet_01v8 ad=0.25 pd=2.25 as=0.92 ps=4.72 w=2 l=0.5
X82 SAR_validpin_0/DFFR_0/a_350_n430# SARclkgen_0/PHIB SAR_validpin_0/DFFR_0/a_1130_520# VDD1v8 sky130_fd_pr__pfet_01v8 ad=1.608572 pd=8.971429 as=1.066667 ps=5.866667 w=4 l=0.5
X83 SAR_validpin_0/DFFR_0/a_1130_520# SAR_validpin_0/DFFR_0/a_450_n400# VDD1v8 VDD1v8 sky130_fd_pr__pfet_01v8 ad=1.066667 pd=5.866667 as=0.905774 ps=5.224219 w=4 l=0.5
X84 SAR_validpin_0/OR2_1/B SAR_validpin_0/DFFR_0/a_2600_n430# VSS VSS sky130_fd_pr__nfet_01v8 ad=0.4 pd=2.8 as=0.310542 ps=1.943976 w=1 l=0.5
X85 SAR_validpin_0/OR2_1/B SAR_validpin_0/DFFR_0/a_2600_n430# VDD1v8 VDD1v8 sky130_fd_pr__pfet_01v8 ad=0.8 pd=4.8 as=0.452887 ps=2.61211 w=2 l=0.5
X86 SAR_validpin_0/DFFR_0/a_90_n400# SAR_validpin_0/DFFR_0/a_n420_n400# SAR_validpin_0/DFFR_0/a_350_n430# VDD1v8 sky130_fd_pr__pfet_01v8 ad=1.38 pd=7.08 as=1.206429 ps=6.728571 w=3 l=0.5
X87 SAR_validpin_0/DFFR_0/a_2600_n430# RST_N VDD1v8 VDD1v8 sky130_fd_pr__pfet_01v8 ad=0.8 pd=4.8 as=0.452887 ps=2.61211 w=2 l=0.5
X88 SAR_validpin_0/DFFR_0/a_450_n400# SAR_validpin_0/DFFR_0/a_350_n430# VDD1v8 VDD1v8 sky130_fd_pr__pfet_01v8 ad=0.8 pd=4.64 as=0.452887 ps=2.61211 w=2 l=0.5
X89 VDD1v8 RST_N SAR_validpin_0/DFFR_0/a_1130_520# VDD1v8 sky130_fd_pr__pfet_01v8 ad=0.905774 pd=5.224219 as=1.066667 ps=5.866667 w=4 l=0.5
X90 VSS SAR_validpin_0/OR2_2/B SAR_validpin_0/DFFR_0/a_90_n400# VSS sky130_fd_pr__nfet_01v8 ad=0.310542 pd=1.943976 as=0.475 ps=2.45 w=1 l=0.5
X91 SAR_validpin_0/DFFR_0/a_2090_n400# SARclkgen_0/PHIA SAR_validpin_0/DFFR_0/a_450_n400# VSS sky130_fd_pr__nfet_01v8 ad=1.425 pd=7.35 as=1.2 ps=7.2 w=3 l=0.5
X92 VDD1v8 SAR_validpin_0/OR2_2/B SAR_validpin_0/DFFR_0/a_90_n400# VDD1v8 sky130_fd_pr__pfet_01v8 ad=0.452887 pd=2.61211 as=0.92 ps=4.72 w=2 l=0.5
X93 SAR_validpin_0/DFFR_0/a_450_n400# SAR_validpin_0/DFFR_0/a_350_n430# VSS VSS sky130_fd_pr__nfet_01v8 ad=0.4 pd=2.4 as=0.310542 ps=1.943976 w=1 l=0.5
X94 SAR_validpin_0/DFFR_0/a_1310_n400# RST_N VSS VSS sky130_fd_pr__nfet_01v8 ad=0.375 pd=3.25 as=0.931626 ps=5.831927 w=3 l=0.5
X95 VDD1v8 SARclkgen_0/PHIB SAR_validpin_0/DFFR_0/a_n420_n400# VDD1v8 sky130_fd_pr__pfet_01v8 ad=0.452887 pd=2.61211 as=0.8 ps=4.8 w=2 l=0.5
X96 SAR_validpin_0/DFFR_0/a_3210_n400# SAR_validpin_0/DFFR_0/a_2090_n400# SAR_validpin_0/DFFR_0/a_2600_n430# VSS sky130_fd_pr__nfet_01v8 ad=0.25 pd=2.25 as=0.8 ps=4.8 w=2 l=0.5
X97 VDD1v8 SAR_validpin_0/DFFR_0/a_2600_n430# SAR_validpin_0/DFFR_0/a_2550_720# VDD1v8 sky130_fd_pr__pfet_01v8 ad=0.452887 pd=2.61211 as=0.25 ps=2.25 w=2 l=0.5
X98 SAR_validpin_0/DFFRR_0/a_n420_720# SAR_validpin_0/DFFRR_0/D VDD1v8 VDD1v8 sky130_fd_pr__pfet_01v8 ad=0.885714 pd=4.742857 as=0.452887 ps=2.61211 w=2 l=0.5
X99 SAR_validpin_0/DFFRR_0/a_2090_n400# SAR_validpin_0/DFFRR_0/a_n560_n400# SAR_validpin_0/DFFRR_0/a_450_n400# VDD1v8 sky130_fd_pr__pfet_01v8 ad=1.38 pd=7.08 as=1.2 ps=6.96 w=3 l=0.5
X100 SAR_validpin_0/DFFRR_0/a_n420_720# SAR_validpin_0/DFFRR_0/D SAR_validpin_0/DFFRR_0/a_n240_n400# VSS sky130_fd_pr__nfet_01v8 ad=0.92 pd=4.72 as=0.25 ps=2.25 w=2 l=0.5
X101 VDD1v8 SAR_validpin_0/DFFRR_0/a_2090_n400# SAR_validpin_0/DFFRR_0/a_2600_n430# VDD1v8 sky130_fd_pr__pfet_01v8 ad=0.452887 pd=2.61211 as=0.8 ps=4.8 w=2 l=0.5
X102 SAR_validpin_0/DFFRR_0/a_n240_n400# SAR_validpin_0/DFFRR_0/a_n340_n430# VSS VSS sky130_fd_pr__nfet_01v8 ad=0.25 pd=2.25 as=0.621084 ps=3.887952 w=2 l=0.5
X103 SAR_validpin_0/DFFRR_0/a_2550_n400# SAR_validpin_0/DFFRR_0/a_n560_n400# SAR_validpin_0/DFFRR_0/a_2090_n400# VSS sky130_fd_pr__nfet_01v8 ad=0.125 pd=1.25 as=0.475 ps=2.45 w=1 l=0.5
X104 VSS SAR_validpin_0/DFFRR_0/a_2600_n430# SAR_validpin_0/DFFRR_0/a_2550_n400# VSS sky130_fd_pr__nfet_01v8 ad=0.310542 pd=1.943976 as=0.125 ps=1.25 w=1 l=0.5
X105 SAR_validpin_0/DFFRR_0/a_1460_n400# SAR_validpin_0/DFFRR_0/a_450_n400# SAR_validpin_0/DFFRR_0/a_1310_n400# VSS sky130_fd_pr__nfet_01v8 ad=0.375 pd=3.25 as=0.375 ps=3.25 w=3 l=0.5
X106 SAR_validpin_0/DFFRR_0/a_350_n430# SAR_validpin_0/DFFRR_0/a_n930_n400# SAR_validpin_0/DFFRR_0/a_1460_n400# VSS sky130_fd_pr__nfet_01v8 ad=1.2 pd=6.8 as=0.375 ps=3.25 w=3 l=0.5
X107 VDD1v8 SARclkgen_0/PHIB SAR_validpin_0/DFFRR_0/a_n930_n400# VDD1v8 sky130_fd_pr__pfet_01v8 ad=0.452887 pd=2.61211 as=0.8 ps=4.8 w=2 l=0.5
X108 VSS RST_N SAR_validpin_0/DFFRR_0/a_3210_n400# VSS sky130_fd_pr__nfet_01v8 ad=0.621084 pd=3.887952 as=0.25 ps=2.25 w=2 l=0.5
X109 SAR_validpin_0/DFFRR_0/a_n420_720# SARclkgen_0/PHIB SAR_validpin_0/DFFRR_0/a_350_n430# VSS sky130_fd_pr__nfet_01v8 ad=1.38 pd=7.08 as=1.2 ps=6.8 w=3 l=0.5
X110 SAR_validpin_0/DFFRR_0/a_2550_720# SARclkgen_0/PHIA SAR_validpin_0/DFFRR_0/a_2090_n400# VDD1v8 sky130_fd_pr__pfet_01v8 ad=0.25 pd=2.25 as=0.92 ps=4.72 w=2 l=0.5
X111 SAR_validpin_0/DFFRR_0/a_350_n430# SARclkgen_0/PHIB SAR_validpin_0/DFFRR_0/a_1130_520# VDD1v8 sky130_fd_pr__pfet_01v8 ad=1.608572 pd=8.971429 as=1.066667 ps=5.866667 w=4 l=0.5
X112 SAR_validpin_0/DFFRR_0/a_1130_520# SAR_validpin_0/DFFRR_0/a_450_n400# VDD1v8 VDD1v8 sky130_fd_pr__pfet_01v8 ad=1.066667 pd=5.866667 as=0.905774 ps=5.224219 w=4 l=0.5
X113 SAR_validpin_0/OR2_1/A SAR_validpin_0/DFFRR_0/a_2600_n430# VSS VSS sky130_fd_pr__nfet_01v8 ad=0.4375 pd=2.425 as=0.310542 ps=1.943976 w=1 l=0.5
X114 SAR_validpin_0/DFFRR_0/a_n560_n400# SARclkgen_0/PHIA VDD1v8 VDD1v8 sky130_fd_pr__pfet_01v8 ad=0.8 pd=4.8 as=0.452887 ps=2.61211 w=2 l=0.5
X115 VSS SARclkgen_0/PHIB SAR_validpin_0/DFFRR_0/a_n930_n400# VSS sky130_fd_pr__nfet_01v8 ad=0.310542 pd=1.943976 as=0.4 ps=2.8 w=1 l=0.5
X116 SAR_validpin_0/OR2_1/A SAR_validpin_0/DFFRR_0/a_2600_n430# VDD1v8 VDD1v8 sky130_fd_pr__pfet_01v8 ad=0.86 pd=4.68 as=0.452887 ps=2.61211 w=2 l=0.5
X117 SAR_validpin_0/DFFRR_0/a_n420_720# SAR_validpin_0/DFFRR_0/a_n930_n400# SAR_validpin_0/DFFRR_0/a_350_n430# VDD1v8 sky130_fd_pr__pfet_01v8 ad=1.328571 pd=7.114286 as=1.206429 ps=6.728571 w=3 l=0.5
X118 SAR_validpin_0/DFFRR_0/a_2600_n430# RST_N VDD1v8 VDD1v8 sky130_fd_pr__pfet_01v8 ad=0.8 pd=4.8 as=0.452887 ps=2.61211 w=2 l=0.5
X119 SAR_validpin_0/DFFRR_0/a_450_n400# SAR_validpin_0/DFFRR_0/a_350_n430# VDD1v8 VDD1v8 sky130_fd_pr__pfet_01v8 ad=0.8 pd=4.64 as=0.452887 ps=2.61211 w=2 l=0.5
X120 SAR_validpin_0/DFFRR_0/a_n560_n400# SARclkgen_0/PHIA VSS VSS sky130_fd_pr__nfet_01v8 ad=0.4 pd=2.8 as=0.310542 ps=1.943976 w=1 l=0.5
X121 VDD1v8 RST_N SAR_validpin_0/DFFRR_0/a_1130_520# VDD1v8 sky130_fd_pr__pfet_01v8 ad=0.905774 pd=5.224219 as=1.066667 ps=5.866667 w=4 l=0.5
X122 VSS shift1v8to5_1/A SAR_validpin_0/DFFRR_0/a_n340_n430# VSS sky130_fd_pr__nfet_01v8 ad=0.310542 pd=1.943976 as=0.4 ps=2.8 w=1 l=0.5
X123 SAR_validpin_0/DFFRR_0/a_2090_n400# SARclkgen_0/PHIA SAR_validpin_0/DFFRR_0/a_450_n400# VSS sky130_fd_pr__nfet_01v8 ad=1.425 pd=7.35 as=1.2 ps=7.2 w=3 l=0.5
X124 VDD1v8 shift1v8to5_1/A SAR_validpin_0/DFFRR_0/a_n340_n430# VDD1v8 sky130_fd_pr__pfet_01v8 ad=0.452887 pd=2.61211 as=0.8 ps=4.8 w=2 l=0.5
X125 SAR_validpin_0/DFFRR_0/a_450_n400# SAR_validpin_0/DFFRR_0/a_350_n430# VSS VSS sky130_fd_pr__nfet_01v8 ad=0.4 pd=2.4 as=0.310542 ps=1.943976 w=1 l=0.5
X126 SAR_validpin_0/DFFRR_0/a_1310_n400# RST_N VSS VSS sky130_fd_pr__nfet_01v8 ad=0.375 pd=3.25 as=0.931626 ps=5.831927 w=3 l=0.5
X127 VDD1v8 SAR_validpin_0/DFFRR_0/a_n340_n430# SAR_validpin_0/DFFRR_0/a_n420_720# VDD1v8 sky130_fd_pr__pfet_01v8 ad=0.452887 pd=2.61211 as=0.885714 ps=4.742857 w=2 l=0.5
X128 SAR_validpin_0/DFFRR_0/a_3210_n400# SAR_validpin_0/DFFRR_0/a_2090_n400# SAR_validpin_0/DFFRR_0/a_2600_n430# VSS sky130_fd_pr__nfet_01v8 ad=0.25 pd=2.25 as=0.8 ps=4.8 w=2 l=0.5
X129 VDD1v8 SAR_validpin_0/DFFRR_0/a_2600_n430# SAR_validpin_0/DFFRR_0/a_2550_720# VDD1v8 sky130_fd_pr__pfet_01v8 ad=0.452887 pd=2.61211 as=0.25 ps=2.25 w=2 l=0.5
X130 SAR_validpin_0/DFFR_1/a_2090_n400# SAR_validpin_0/DFFR_1/a_n50_n400# SAR_validpin_0/DFFR_1/a_450_n400# VDD1v8 sky130_fd_pr__pfet_01v8 ad=1.38 pd=7.08 as=1.2 ps=6.96 w=3 l=0.5
X131 VDD1v8 SAR_validpin_0/DFFR_1/a_2090_n400# SAR_validpin_0/DFFR_1/a_2600_n430# VDD1v8 sky130_fd_pr__pfet_01v8 ad=0.452887 pd=2.61211 as=0.8 ps=4.8 w=2 l=0.5
X132 VSS SARclkgen_0/PHIB SAR_validpin_0/DFFR_1/a_n420_n400# VSS sky130_fd_pr__nfet_01v8 ad=0.310542 pd=1.943976 as=0.4 ps=2.8 w=1 l=0.5
X133 SAR_validpin_0/DFFR_1/a_2550_n400# SAR_validpin_0/DFFR_1/a_n50_n400# SAR_validpin_0/DFFR_1/a_2090_n400# VSS sky130_fd_pr__nfet_01v8 ad=0.125 pd=1.25 as=0.475 ps=2.45 w=1 l=0.5
X134 VSS SAR_validpin_0/DFFR_1/a_2600_n430# SAR_validpin_0/DFFR_1/a_2550_n400# VSS sky130_fd_pr__nfet_01v8 ad=0.310542 pd=1.943976 as=0.125 ps=1.25 w=1 l=0.5
X135 SAR_validpin_0/DFFR_1/a_1460_n400# SAR_validpin_0/DFFR_1/a_450_n400# SAR_validpin_0/DFFR_1/a_1310_n400# VSS sky130_fd_pr__nfet_01v8 ad=0.375 pd=3.25 as=0.375 ps=3.25 w=3 l=0.5
X136 SAR_validpin_0/DFFR_1/a_350_n430# SAR_validpin_0/DFFR_1/a_n420_n400# SAR_validpin_0/DFFR_1/a_1460_n400# VSS sky130_fd_pr__nfet_01v8 ad=1.2 pd=6.8 as=0.375 ps=3.25 w=3 l=0.5
X137 VSS RST_N SAR_validpin_0/DFFR_1/a_3210_n400# VSS sky130_fd_pr__nfet_01v8 ad=0.621084 pd=3.887952 as=0.25 ps=2.25 w=2 l=0.5
X138 SAR_validpin_0/DFFR_1/a_90_n400# SARclkgen_0/PHIB SAR_validpin_0/DFFR_1/a_350_n430# VSS sky130_fd_pr__nfet_01v8 ad=1.425 pd=7.35 as=1.2 ps=6.8 w=3 l=0.5
X139 SAR_validpin_0/DFFR_1/a_n50_n400# SARclkgen_0/PHIA VDD1v8 VDD1v8 sky130_fd_pr__pfet_01v8 ad=0.8 pd=4.8 as=0.452887 ps=2.61211 w=2 l=0.5
X140 SAR_validpin_0/DFFR_1/a_n50_n400# SARclkgen_0/PHIA VSS VSS sky130_fd_pr__nfet_01v8 ad=0.4 pd=2.8 as=0.310542 ps=1.943976 w=1 l=0.5
X141 SAR_validpin_0/DFFR_1/a_2550_720# SARclkgen_0/PHIA SAR_validpin_0/DFFR_1/a_2090_n400# VDD1v8 sky130_fd_pr__pfet_01v8 ad=0.25 pd=2.25 as=0.92 ps=4.72 w=2 l=0.5
X142 SAR_validpin_0/DFFR_1/a_350_n430# SARclkgen_0/PHIB SAR_validpin_0/DFFR_1/a_1130_520# VDD1v8 sky130_fd_pr__pfet_01v8 ad=1.608572 pd=8.971429 as=1.066667 ps=5.866667 w=4 l=0.5
X143 SAR_validpin_0/DFFR_1/a_1130_520# SAR_validpin_0/DFFR_1/a_450_n400# VDD1v8 VDD1v8 sky130_fd_pr__pfet_01v8 ad=1.066667 pd=5.866667 as=0.905774 ps=5.224219 w=4 l=0.5
X144 SAR_validpin_0/OR2_0/B SAR_validpin_0/DFFR_1/a_2600_n430# VSS VSS sky130_fd_pr__nfet_01v8 ad=0.4 pd=2.8 as=0.310542 ps=1.943976 w=1 l=0.5
X145 SAR_validpin_0/OR2_0/B SAR_validpin_0/DFFR_1/a_2600_n430# VDD1v8 VDD1v8 sky130_fd_pr__pfet_01v8 ad=0.8 pd=4.8 as=0.452887 ps=2.61211 w=2 l=0.5
X146 SAR_validpin_0/DFFR_1/a_90_n400# SAR_validpin_0/DFFR_1/a_n420_n400# SAR_validpin_0/DFFR_1/a_350_n430# VDD1v8 sky130_fd_pr__pfet_01v8 ad=1.38 pd=7.08 as=1.206429 ps=6.728571 w=3 l=0.5
X147 SAR_validpin_0/DFFR_1/a_2600_n430# RST_N VDD1v8 VDD1v8 sky130_fd_pr__pfet_01v8 ad=0.8 pd=4.8 as=0.452887 ps=2.61211 w=2 l=0.5
X148 SAR_validpin_0/DFFR_1/a_450_n400# SAR_validpin_0/DFFR_1/a_350_n430# VDD1v8 VDD1v8 sky130_fd_pr__pfet_01v8 ad=0.8 pd=4.64 as=0.452887 ps=2.61211 w=2 l=0.5
X149 VDD1v8 RST_N SAR_validpin_0/DFFR_1/a_1130_520# VDD1v8 sky130_fd_pr__pfet_01v8 ad=0.905774 pd=5.224219 as=1.066667 ps=5.866667 w=4 l=0.5
X150 VSS SAR_validpin_0/OR2_1/B SAR_validpin_0/DFFR_1/a_90_n400# VSS sky130_fd_pr__nfet_01v8 ad=0.310542 pd=1.943976 as=0.475 ps=2.45 w=1 l=0.5
X151 SAR_validpin_0/DFFR_1/a_2090_n400# SARclkgen_0/PHIA SAR_validpin_0/DFFR_1/a_450_n400# VSS sky130_fd_pr__nfet_01v8 ad=1.425 pd=7.35 as=1.2 ps=7.2 w=3 l=0.5
X152 VDD1v8 SAR_validpin_0/OR2_1/B SAR_validpin_0/DFFR_1/a_90_n400# VDD1v8 sky130_fd_pr__pfet_01v8 ad=0.452887 pd=2.61211 as=0.92 ps=4.72 w=2 l=0.5
X153 SAR_validpin_0/DFFR_1/a_450_n400# SAR_validpin_0/DFFR_1/a_350_n430# VSS VSS sky130_fd_pr__nfet_01v8 ad=0.4 pd=2.4 as=0.310542 ps=1.943976 w=1 l=0.5
X154 SAR_validpin_0/DFFR_1/a_1310_n400# RST_N VSS VSS sky130_fd_pr__nfet_01v8 ad=0.375 pd=3.25 as=0.931626 ps=5.831927 w=3 l=0.5
X155 VDD1v8 SARclkgen_0/PHIB SAR_validpin_0/DFFR_1/a_n420_n400# VDD1v8 sky130_fd_pr__pfet_01v8 ad=0.452887 pd=2.61211 as=0.8 ps=4.8 w=2 l=0.5
X156 SAR_validpin_0/DFFR_1/a_3210_n400# SAR_validpin_0/DFFR_1/a_2090_n400# SAR_validpin_0/DFFR_1/a_2600_n430# VSS sky130_fd_pr__nfet_01v8 ad=0.25 pd=2.25 as=0.8 ps=4.8 w=2 l=0.5
X157 VDD1v8 SAR_validpin_0/DFFR_1/a_2600_n430# SAR_validpin_0/DFFR_1/a_2550_720# VDD1v8 sky130_fd_pr__pfet_01v8 ad=0.452887 pd=2.61211 as=0.25 ps=2.25 w=2 l=0.5
X158 SAR_validpin_0/DFFRR_1/a_n420_720# SAR_validpin_0/DFFRR_1/D VDD1v8 VDD1v8 sky130_fd_pr__pfet_01v8 ad=0.885714 pd=4.742857 as=0.452887 ps=2.61211 w=2 l=0.5
X159 SAR_validpin_0/DFFRR_1/a_2090_n400# SAR_validpin_0/DFFRR_1/a_n560_n400# SAR_validpin_0/DFFRR_1/a_450_n400# VDD1v8 sky130_fd_pr__pfet_01v8 ad=1.38 pd=7.08 as=1.2 ps=6.96 w=3 l=0.5
X160 SAR_validpin_0/DFFRR_1/a_n420_720# SAR_validpin_0/DFFRR_1/D SAR_validpin_0/DFFRR_1/a_n240_n400# VSS sky130_fd_pr__nfet_01v8 ad=0.92 pd=4.72 as=0.25 ps=2.25 w=2 l=0.5
X161 VDD1v8 SAR_validpin_0/DFFRR_1/a_2090_n400# SAR_validpin_0/DFFRR_1/a_2600_n430# VDD1v8 sky130_fd_pr__pfet_01v8 ad=0.452887 pd=2.61211 as=0.8 ps=4.8 w=2 l=0.5
X162 SAR_validpin_0/DFFRR_1/a_n240_n400# SAR_validpin_0/DFFRR_1/a_n340_n430# VSS VSS sky130_fd_pr__nfet_01v8 ad=0.25 pd=2.25 as=0.621084 ps=3.887952 w=2 l=0.5
X163 SAR_validpin_0/DFFRR_1/a_2550_n400# SAR_validpin_0/DFFRR_1/a_n560_n400# SAR_validpin_0/DFFRR_1/a_2090_n400# VSS sky130_fd_pr__nfet_01v8 ad=0.125 pd=1.25 as=0.475 ps=2.45 w=1 l=0.5
X164 VSS SAR_validpin_0/DFFRR_1/a_2600_n430# SAR_validpin_0/DFFRR_1/a_2550_n400# VSS sky130_fd_pr__nfet_01v8 ad=0.310542 pd=1.943976 as=0.125 ps=1.25 w=1 l=0.5
X165 SAR_validpin_0/DFFRR_1/a_1460_n400# SAR_validpin_0/DFFRR_1/a_450_n400# SAR_validpin_0/DFFRR_1/a_1310_n400# VSS sky130_fd_pr__nfet_01v8 ad=0.375 pd=3.25 as=0.375 ps=3.25 w=3 l=0.5
X166 SAR_validpin_0/DFFRR_1/a_350_n430# SAR_validpin_0/DFFRR_1/a_n930_n400# SAR_validpin_0/DFFRR_1/a_1460_n400# VSS sky130_fd_pr__nfet_01v8 ad=1.2 pd=6.8 as=0.375 ps=3.25 w=3 l=0.5
X167 VDD1v8 SARclkgen_0/PHIB SAR_validpin_0/DFFRR_1/a_n930_n400# VDD1v8 sky130_fd_pr__pfet_01v8 ad=0.452887 pd=2.61211 as=0.8 ps=4.8 w=2 l=0.5
X168 VSS RST_N SAR_validpin_0/DFFRR_1/a_3210_n400# VSS sky130_fd_pr__nfet_01v8 ad=0.621084 pd=3.887952 as=0.25 ps=2.25 w=2 l=0.5
X169 SAR_validpin_0/DFFRR_1/a_n420_720# SARclkgen_0/PHIB SAR_validpin_0/DFFRR_1/a_350_n430# VSS sky130_fd_pr__nfet_01v8 ad=1.38 pd=7.08 as=1.2 ps=6.8 w=3 l=0.5
X170 SAR_validpin_0/DFFRR_1/a_2550_720# SARclkgen_0/PHIA SAR_validpin_0/DFFRR_1/a_2090_n400# VDD1v8 sky130_fd_pr__pfet_01v8 ad=0.25 pd=2.25 as=0.92 ps=4.72 w=2 l=0.5
X171 SAR_validpin_0/DFFRR_1/a_350_n430# SARclkgen_0/PHIB SAR_validpin_0/DFFRR_1/a_1130_520# VDD1v8 sky130_fd_pr__pfet_01v8 ad=1.608572 pd=8.971429 as=1.066667 ps=5.866667 w=4 l=0.5
X172 SAR_validpin_0/DFFRR_1/a_1130_520# SAR_validpin_0/DFFRR_1/a_450_n400# VDD1v8 VDD1v8 sky130_fd_pr__pfet_01v8 ad=1.066667 pd=5.866667 as=0.905774 ps=5.224219 w=4 l=0.5
X173 SAR_validpin_0/OR2_0/A SAR_validpin_0/DFFRR_1/a_2600_n430# VSS VSS sky130_fd_pr__nfet_01v8 ad=0.4375 pd=2.425 as=0.310542 ps=1.943976 w=1 l=0.5
X174 SAR_validpin_0/DFFRR_1/a_n560_n400# SARclkgen_0/PHIA VDD1v8 VDD1v8 sky130_fd_pr__pfet_01v8 ad=0.8 pd=4.8 as=0.452887 ps=2.61211 w=2 l=0.5
X175 VSS SARclkgen_0/PHIB SAR_validpin_0/DFFRR_1/a_n930_n400# VSS sky130_fd_pr__nfet_01v8 ad=0.310542 pd=1.943976 as=0.4 ps=2.8 w=1 l=0.5
X176 SAR_validpin_0/OR2_0/A SAR_validpin_0/DFFRR_1/a_2600_n430# VDD1v8 VDD1v8 sky130_fd_pr__pfet_01v8 ad=0.86 pd=4.68 as=0.452887 ps=2.61211 w=2 l=0.5
X177 SAR_validpin_0/DFFRR_1/a_n420_720# SAR_validpin_0/DFFRR_1/a_n930_n400# SAR_validpin_0/DFFRR_1/a_350_n430# VDD1v8 sky130_fd_pr__pfet_01v8 ad=1.328571 pd=7.114286 as=1.206429 ps=6.728571 w=3 l=0.5
X178 SAR_validpin_0/DFFRR_1/a_2600_n430# RST_N VDD1v8 VDD1v8 sky130_fd_pr__pfet_01v8 ad=0.8 pd=4.8 as=0.452887 ps=2.61211 w=2 l=0.5
X179 SAR_validpin_0/DFFRR_1/a_450_n400# SAR_validpin_0/DFFRR_1/a_350_n430# VDD1v8 VDD1v8 sky130_fd_pr__pfet_01v8 ad=0.8 pd=4.64 as=0.452887 ps=2.61211 w=2 l=0.5
X180 SAR_validpin_0/DFFRR_1/a_n560_n400# SARclkgen_0/PHIA VSS VSS sky130_fd_pr__nfet_01v8 ad=0.4 pd=2.8 as=0.310542 ps=1.943976 w=1 l=0.5
X181 VDD1v8 RST_N SAR_validpin_0/DFFRR_1/a_1130_520# VDD1v8 sky130_fd_pr__pfet_01v8 ad=0.905774 pd=5.224219 as=1.066667 ps=5.866667 w=4 l=0.5
X182 VSS shift1v8to5_1/A SAR_validpin_0/DFFRR_1/a_n340_n430# VSS sky130_fd_pr__nfet_01v8 ad=0.310542 pd=1.943976 as=0.4 ps=2.8 w=1 l=0.5
X183 SAR_validpin_0/DFFRR_1/a_2090_n400# SARclkgen_0/PHIA SAR_validpin_0/DFFRR_1/a_450_n400# VSS sky130_fd_pr__nfet_01v8 ad=1.425 pd=7.35 as=1.2 ps=7.2 w=3 l=0.5
X184 VDD1v8 shift1v8to5_1/A SAR_validpin_0/DFFRR_1/a_n340_n430# VDD1v8 sky130_fd_pr__pfet_01v8 ad=0.452887 pd=2.61211 as=0.8 ps=4.8 w=2 l=0.5
X185 SAR_validpin_0/DFFRR_1/a_450_n400# SAR_validpin_0/DFFRR_1/a_350_n430# VSS VSS sky130_fd_pr__nfet_01v8 ad=0.4 pd=2.4 as=0.310542 ps=1.943976 w=1 l=0.5
X186 SAR_validpin_0/DFFRR_1/a_1310_n400# RST_N VSS VSS sky130_fd_pr__nfet_01v8 ad=0.375 pd=3.25 as=0.931626 ps=5.831927 w=3 l=0.5
X187 VDD1v8 SAR_validpin_0/DFFRR_1/a_n340_n430# SAR_validpin_0/DFFRR_1/a_n420_720# VDD1v8 sky130_fd_pr__pfet_01v8 ad=0.452887 pd=2.61211 as=0.885714 ps=4.742857 w=2 l=0.5
X188 SAR_validpin_0/DFFRR_1/a_3210_n400# SAR_validpin_0/DFFRR_1/a_2090_n400# SAR_validpin_0/DFFRR_1/a_2600_n430# VSS sky130_fd_pr__nfet_01v8 ad=0.25 pd=2.25 as=0.8 ps=4.8 w=2 l=0.5
X189 VDD1v8 SAR_validpin_0/DFFRR_1/a_2600_n430# SAR_validpin_0/DFFRR_1/a_2550_720# VDD1v8 sky130_fd_pr__pfet_01v8 ad=0.452887 pd=2.61211 as=0.25 ps=2.25 w=2 l=0.5
X190 SAR_validpin_0/DFFR_3/a_2090_n400# SAR_validpin_0/DFFR_3/a_n50_n400# SAR_validpin_0/DFFR_3/a_450_n400# VDD1v8 sky130_fd_pr__pfet_01v8 ad=1.38 pd=7.08 as=1.2 ps=6.96 w=3 l=0.5
X191 VDD1v8 SAR_validpin_0/DFFR_3/a_2090_n400# SAR_validpin_0/DFFR_3/a_2600_n430# VDD1v8 sky130_fd_pr__pfet_01v8 ad=0.452887 pd=2.61211 as=0.8 ps=4.8 w=2 l=0.5
X192 VSS SAR_validpin_0/AND2_1/Y SAR_validpin_0/DFFR_3/a_n420_n400# VSS sky130_fd_pr__nfet_01v8 ad=0.310542 pd=1.943976 as=0.4 ps=2.8 w=1 l=0.5
X193 SAR_validpin_0/DFFR_3/a_2550_n400# SAR_validpin_0/DFFR_3/a_n50_n400# SAR_validpin_0/DFFR_3/a_2090_n400# VSS sky130_fd_pr__nfet_01v8 ad=0.125 pd=1.25 as=0.475 ps=2.45 w=1 l=0.5
X194 VSS SAR_validpin_0/DFFR_3/a_2600_n430# SAR_validpin_0/DFFR_3/a_2550_n400# VSS sky130_fd_pr__nfet_01v8 ad=0.310542 pd=1.943976 as=0.125 ps=1.25 w=1 l=0.5
X195 SAR_validpin_0/DFFR_3/a_1460_n400# SAR_validpin_0/DFFR_3/a_450_n400# SAR_validpin_0/DFFR_3/a_1310_n400# VSS sky130_fd_pr__nfet_01v8 ad=0.375 pd=3.25 as=0.375 ps=3.25 w=3 l=0.5
X196 SAR_validpin_0/DFFR_3/a_350_n430# SAR_validpin_0/DFFR_3/a_n420_n400# SAR_validpin_0/DFFR_3/a_1460_n400# VSS sky130_fd_pr__nfet_01v8 ad=1.2 pd=6.8 as=0.375 ps=3.25 w=3 l=0.5
X197 VSS RST_N SAR_validpin_0/DFFR_3/a_3210_n400# VSS sky130_fd_pr__nfet_01v8 ad=0.621084 pd=3.887952 as=0.25 ps=2.25 w=2 l=0.5
X198 SAR_validpin_0/DFFR_3/a_90_n400# SAR_validpin_0/AND2_1/Y SAR_validpin_0/DFFR_3/a_350_n430# VSS sky130_fd_pr__nfet_01v8 ad=1.425 pd=7.35 as=1.2 ps=6.8 w=3 l=0.5
X199 SAR_validpin_0/DFFR_3/a_n50_n400# SAR_validpin_0/AND2_0/Y VDD1v8 VDD1v8 sky130_fd_pr__pfet_01v8 ad=0.8 pd=4.8 as=0.452887 ps=2.61211 w=2 l=0.5
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
