jackm2983/SENIOR-PROJECT/ADC/4bit_C2C/MagicAndSpice/inverter_sch.spice

** sch_path: /home/ee431/workspace/6SAR_CDAC/EE431_FinalProj/inverter.sch
.subckt inverter A Y VP VN
*.PININFO A:I Y:O VP:B VN:B
XM1 Y A VP VP sky130_fd_pr__pfet_01v8 L=0.5 W=2 nf=1 ad='int((nf+1)/2) * W/nf * 0.29' as='int((nf+2)/2) * W/nf * 0.29'
+ pd='2*int((nf+1)/2) * (W/nf + 0.29)' ps='2*int((nf+2)/2) * (W/nf + 0.29)' nrd='0.29 / W' nrs='0.29 / W'
+ sa=0 sb=0 sd=0 mult=1 m=1
XM2 Y A VN VN sky130_fd_pr__nfet_01v8 L=0.5 W=1 nf=1 ad='int((nf+1)/2) * W/nf * 0.29' as='int((nf+2)/2) * W/nf * 0.29'
+ pd='2*int((nf+1)/2) * (W/nf + 0.29)' ps='2*int((nf+2)/2) * (W/nf + 0.29)' nrd='0.29 / W' nrs='0.29 / W'
+ sa=0 sb=0 sd=0 mult=1 m=1
.ends
.end
