jackm2983/SENIOR-PROJECT/FPGA/FPGA_Encoder+SNN+UART/SNN_Encoder.srcs/sim_1/new/tb_system_top_wrapper.sv

`timescale 1ns / 1ps

// ============================================================================
// System Top Wrapper Testbench
// ============================================================================
// Self-contained test that exercises every path:
//   Test A: UART input + Encoding mode (all 4 encoders)
//   Test B: UART input + SNN mode
//   Test C: ADC (xadc stub) input + SNN mode
//
// Uses scaled CLK_FREQ so sim completes in reasonable time. The ratio between
// clock and baud is preserved so bit timing is identical to hardware.
//
// Run duration: a "run all" will complete on $finish in ~50-100 us of sim time.
// ============================================================================

module tb_system_top_wrapper;

    // scaled params for faster sim
    localparam int CLK_FREQ = 1_000_000;     // 1 MHz sim clock
    localparam int BAUD = 115200;
    localparam int DATA_W = 12;
    localparam int BIT_CLKS = CLK_FREQ / BAUD;  // ~9 cycles per bit (tiny)
    
    // clamp - ensure at least a few cycles per bit
    localparam int BIT_CLKS_SAFE = (BIT_CLKS < 4) ? 4 : BIT_CLKS;
    
    // ============ DUT signals ============
    logic clk = 0;
    logic rst = 1;
    logic uart_rx_pin = 1;  // idle high
    logic uart_tx_pin;
    logic vauxp6 = 0;
    logic vauxn6 = 0;
    logic [1:0] input_select = 2'b00;
    logic [1:0] process_mode_select = 2'b00;
    logic [1:0] encoding_select = 2'b00;
    logic [7:0] status_led;
    
    // 1 MHz clock → 1 us period, 500 ns half period
    always #500 clk = ~clk;
    
    // ============ DUT ============
    system_top_wrapper #(
        .DATA_WIDTH(DATA_W),
        .BAUD_RATE(BAUD),
        .CLK_FREQ(CLK_FREQ),
        .XADC_DECIMATION(3)  // small for fast sim
    ) dut (
        .clk(clk),
        .rst(rst),
        .uart_rx(uart_rx_pin),
        .uart_tx(uart_tx_pin),
        .vauxp6(vauxp6),
        .vauxn6(vauxn6),
        .input_select(input_select),
        .process_mode_select(process_mode_select),
        .encoding_select(encoding_select),
        .status_led(status_led)
    );
    
    // ============ UART send (host -> DUT) ============
    // bit-bangs a 12-bit frame: start(0), 12 data LSB first, stop(1)
    task automatic uart_send(input logic [DATA_W-1:0] val);
        int i;
        $display("    [TB] sending 0x%03h over UART", val);
        @(posedge clk);
        uart_rx_pin = 1'b0;
        repeat (BIT_CLKS_SAFE) @(posedge clk);
        for (i = 0; i < DATA_W; i++) begin
            uart_rx_pin = val[i];
            repeat (BIT_CLKS_SAFE) @(posedge clk);
        end
        uart_rx_pin = 1'b1;
        repeat (BIT_CLKS_SAFE) @(posedge clk);
        repeat (BIT_CLKS_SAFE) @(posedge clk);  // idle gap
    endtask
    
    // ============ UART receive (DUT -> host) ============
    // samples one frame from uart_tx_pin, returns the 12-bit value
    task automatic uart_receive(output logic [DATA_W-1:0] val,
                                input int timeout_cycles);
        int i, wait_cnt;
        val = '0;
        wait_cnt = 0;
        // wait for start bit (falling edge)
        while (uart_tx_pin == 1'b1 && wait_cnt < timeout_cycles) begin
            @(posedge clk);
            wait_cnt++;
        end
        if (wait_cnt >= timeout_cycles) begin
            $display("    [TB] RX timeout, no frame seen");
            val = 'x;
            return;
        end
        // align to middle of start bit
        repeat (BIT_CLKS_SAFE / 2) @(posedge clk);
        // sample each data bit at its center
        for (i = 0; i < DATA_W; i++) begin
            repeat (BIT_CLKS_SAFE) @(posedge clk);
            val[i] = uart_tx_pin;
        end
        // skip stop bit
        repeat (BIT_CLKS_SAFE) @(posedge clk);
        $display("    [TB] received 0x%03h from UART TX", val);
    endtask
    
    // ============ Test tracking ============
    int pass_cnt = 0;
    int fail_cnt = 0;
    logic [DATA_W-1:0] got;
    
    task automatic check(input string name,
                         input logic [DATA_W-1:0] actual,
                         input logic [DATA_W-1:0] expected,
                         input logic [DATA_W-1:0] mask);
        if ((actual & mask) === (expected & mask)) begin
            $display("    PASS: %s (got 0x%03h, checked bits 0x%03h)",
                     name, actual, mask);
            pass_cnt++;
        end else begin
            $display("    FAIL: %s (expected 0x%03h, got 0x%03h, mask 0x%03h)",
                     name, expected, actual, mask);
            fail_cnt++;
        end
    endtask
    
    // ============ Main ============
    initial begin
        $display("========================================================");
        $display("  SYSTEM TOP WRAPPER TESTBENCH");
        $display("========================================================");
        $display("  CLK_FREQ = %0d Hz (scaled)", CLK_FREQ);
        $display("  BAUD     = %0d", BAUD);
        $display("  BIT_CLKS = %0d cycles per UART bit", BIT_CLKS_SAFE);
        $display("========================================================");
        
        #5000 rst = 0;
        #2000;
        
        // ─────────────────────────────────────────────────────────────
        // Test A: UART -> Encoding (all 4 encoders)
        // ─────────────────────────────────────────────────────────────
        input_select = 2'b00;
        process_mode_select = 2'b00;
        
        for (int enc_mode = 0; enc_mode < 4; enc_mode++) begin
            string enc_name[4] = '{"rate", "temporal", "delta", "multispike"};
            $display("");
            $display("[Test A%0d] UART -> %s encoding", enc_mode, enc_name[enc_mode]);
            encoding_select = enc_mode[1:0];
            @(posedge clk);
            
            fork
                begin
                    uart_send(12'h3A5);
                end
                begin
                    uart_receive(got, 200 * BIT_CLKS_SAFE);
                    // encoding output = {input_data[9:0], spikeP, spikeN}
                    // input 0x3A5, lower 10 bits = 0x3A5 (fits, upper 2 bits are 0)
                    // shifted left by 2 for packing = 0x3A5 << 2 = 0xE94
                    // mask 0xFFC checks only the upper 10 bits (ignores spike bits)
                    check($sformatf("A%0d ecg bits", enc_mode),
                          got, 12'hE94, 12'hFFC);
                    // spike bits are data-dependent; not checked
                end
            join
            
            #10000;
        end
        
        // ─────────────────────────────────────────────────────────────
        // Test B: UART -> SNN
        // ─────────────────────────────────────────────────────────────
        $display("");
        $display("[Test B] UART -> SNN classification");
        process_mode_select = 2'b01;
        @(posedge clk);
        
        fork
            begin
                // send a few samples to get the SNN stimulated
                uart_send(12'h7FF);
                #20000;
                uart_send(12'h400);
                #20000;
                uart_send(12'h7FF);
            end
            begin
                uart_receive(got, 500 * BIT_CLKS_SAFE);
                // snn output = {5'b0, winner[2:0], fire[4:0]}... wait, let's
                // look at actual format: {7'b0, snn_winner, snn_fire}
                // where snn_winner is N_neurons=5 bits, snn_fire is 5 bits
                // but DATA_WIDTH is 12, so only 5+5+2=12 bits packed oddly
                // (the 7'b0 gets truncated implicitly)
                // just check: upper bits should be valid, winner in 0..4
                $display("    [Test B] got 0x%03h, winner=0x%02h, fire=0b%05b",
                         got, got[9:5], got[4:0]);
                // sanity: at least the frame came through
                if (got !== 'x) begin
                    $display("    PASS: SNN produced output frame");
                    pass_cnt++;
                end else begin
                    $display("    FAIL: no SNN output");
                    fail_cnt++;
                end
            end
        join
        
        #10000;
        
        // ─────────────────────────────────────────────────────────────
        // Test C: ADC (xadc stub) -> SNN
        // ─────────────────────────────────────────────────────────────
        $display("");
        $display("[Test C] ADC (stub ramp) -> SNN classification");
        input_select = 2'b01;
        process_mode_select = 2'b01;
        @(posedge clk);
        
        fork
            begin
                // just wait; xadc stub auto-generates samples
                #200000;
            end
            begin
                uart_receive(got, 1000 * BIT_CLKS_SAFE);
                $display("    [Test C] got 0x%03h from ADC->SNN path", got);
                if (got !== 'x) begin
                    $display("    PASS: ADC input path works end-to-end");
                    pass_cnt++;
                end else begin
                    $display("    FAIL: no output from ADC path");
                    fail_cnt++;
                end
            end
        join
        
        // ─────────────────────────────────────────────────────────────
        #10000;
        $display("");
        $display("========================================================");
        $display("  FINAL RESULTS: %0d passed, %0d failed", pass_cnt, fail_cnt);
        if (fail_cnt == 0)
            $display("  ALL TESTS PASSED");
        else
            $display("  SOME TESTS FAILED");
        $display("========================================================");
        
        $finish;
    end
    
    // hard timeout
    initial begin
        #50_000_000;  // 50 ms sim time
        $display("[TB] HARD TIMEOUT");
        $finish;
    end

endmodule
