jackm2983/SENIOR-PROJECT/(commit log)

2026-02-06 sar adc pdf
2026-02-06 strong arm latch
2026-02-22 Delta mod multi-drive fixed
    synthesizes on vivado, not in the librelane linter, freak my freaking chungus life
    [delta_mod.sv]
2026-02-23 Fix image path case sensitivity in README
2026-04-20 added UART and SNN functionality for FPGA implementation
2026-04-21 added adc testbench
2026-04-21 renamed folder
    [CDAC_4bit_VCM_simplified.sch, CDAC_4bit_VCM_simplified_TB.sch, SPDT.sch, SPDT_TB.sch, T_gate.sch, T_gate_TB.sch, inverter_5v.sch, inverter_5v_TB.sch]
2026-04-22 camerons latest cdac stuff
    [2_Stage_OP_AMP.sch, AND2.sch, CDAC_4bit_VCM_simplified.sch, CDAC_4bit_VCM_simplified_TB.sch, CDAC_4bit_VCM_simplified_TB_inverter_test2_apr19_clkdelaycomp_invimprove.sch, DAC.sch, DFFRN.sch, DFFRNRS.sch]
2026-04-22 fixed the level shifters
    [CDAC_4bit_VCM_simplified_TB_inverter_test2_apr19_clkdelaycomp_invimprove.sch, old_CDAC_4bit_VCM_simplified_TB_inverter_test2_apr19_clkdelaycomp_invimprove.sch, old_inverter_1v8_to_5v.sch, shift_1v8_to_5v.sch, shift_1v8_to_5v_TB.sch, shift_5v_to_1v8.sch, shift_5v_to_1v8_TB.sch, shift_down_tb.sch]
2026-04-22 VCM voltage divider
    [CDAC_4bit_VCM_simplified_TB_inverter_test2_apr19_clkdelaycomp_invimprove.sch]
2026-04-22 fixed the SAR's adc outputs
    [AND2.sch, AND2_TB.sch, CDAC_4bit_VCM_simplified_TB_inverter_test2_apr19_clkdelaycomp_invimprove.sch, SAR.sch]
2026-04-24 minor changes
    [CDAC_4bit_VCM_simplified_TB_inverter_test2_apr19_clkdelaycomp_invimprove.sch, SAR.sch]
2026-04-24 fixed some setup/hold stuff and added the python stuff for UART
    [fpga_results.csv]
2026-04-28 made level shifter widths smaller and more standardized
    [shift_1v8_to_5v.sch, shift_5v_to_1v8.sch]
2026-04-29 to match a youtube video, I made the capacitors _1 instead of _2 and the resistors res_xhigh instead of res_high
    [CDAC_4bit_VCM_simplified.sch, CDAC_4bit_VCM_simplified_TB_inverter_test2_apr19_clkdelaycomp_invimprove.sch, SAR.sch, SAR_tb.sch]
2026-05-01 strongarm
    "i strongarm him like i play the trumpet" - Mac Miller
2026-05-03 AND5V, SR5V, CDAC
    versace large print on my sweater sleave
2026-05-06 ADC finished, errors fixed, need to find fictitious DRC errors from jack
    i drank 1.53 liters of pinnaple juice today
2026-05-08 strongarm, latch, and shifters all pass LVS. CDAC and SAR have errors.
    TOP level testbench also works. changed some stuff with the .tran settings and changed clk transitions to 10n instead of 0.1n.
    [CDAC_4bit_VCM_simplified_TB_inverter_test2_apr19_clkdelaycomp_invimprove.sch, SR_latch.sch, T_gate.sch, strongarm_comp.sch]
2026-05-08 fixed a couple errors with the CDAC. clk and clkbar are still swapped in magic though on the Tgate.
    [CDAC_4bit_VCM_simplified.sch, CDAC_4bit_VCM_simplified_TB_inverter_test2_apr19_clkdelaycomp_invimprove.sch]
2026-05-09 everything matches LVS now except the top layer
    [ADC.sch, SAR_validpin.sch, TGATE.sch]
2026-05-09 Updated ADC.sch
    [ADC.sch]
2026-05-09 set the digital asic stuff up
    [macro_placement.cfg]
2026-05-10 fixed NOT5V. working on a valid pin implementation
    [ADC_validpin.sch, NOT5V.sch, SAR_validpin.sch]
2026-05-10 ADC_valid testbench works. verilog modified. not just have to fix the top level magic file
    [ADC.sch, ADC_validpin.sch, ADC_validpin_TB.sch, TGATE.sch]
2026-05-10 adjusted verilog so that it resets adc after every read
    [TOP_wrapper.sv]
2026-05-10 fixed the no adc version too
    [TOP_no_adc.sv]
2026-05-10 verilog and new magic and schematic files for PHIA and PHIB clk gen. now just need top level
    [ADC_validpin.sch, ADC_validpin_TB.sch, SARclkgen.sch]
2026-05-10 some fixes so it compiles with verilator
    [TOP_no_adc.sv, delta_mod.sv, temporal_mod.sv]
2026-05-11 LVS passes on the top level!!!
    [SARclkgen.sch]
2026-05-11 cleaner testbench
    [ADC_validpin.sch, ADC_validpin_TB.sch]
2026-05-11 config file i forgot to upload
    [macro_placement.cfg]
2026-05-11 adc folder rename to 4 bit
    [2_Stage_OP_AMP.sch, ADC.sch, ADC_validpin.sch, ADC_validpin_TB.sch, AND2.sch, AND2_TB.sch, CDAC_4bit_VCM_simplified.sch, CDAC_4bit_VCM_simplified_TB_inverter_test2_apr19_clkdelaycomp_invimprove.sch]
2026-05-12 testbench has a better printout
    [ADC_validpin_TB.sch]
2026-05-12 update makefile
    [macro_placement.cfg]
2026-05-13 fixed verilog to zero pad
    [TOP_wrapper.sv, delta_mod.sv, multispike_mod.sv, rate_mod.sv, temporal_mod.sv]
2026-05-13 fixed rtl and simulation
    [TOP_no_adc_tb.sv, TOP_wrapper.sv, multispike_mod.sv, temporal_mod.sv]
2026-05-13 encoding schemes with 4bit adc demo screenshot
2026-05-25 changed stuff to get the modulation results to work. before only delta worked.
    [fpga_results.csv]
2026-05-25 made delta less sensitive
    [fpga_results.csv]
2026-05-29 fixed a bug with the RST_N, added image for it, and can plot adc error with python function
    [ADC_validpin_TB.sch]
